salvogendut/V9958-tester/revision-b2-sram/firmware/README.md

# Revision B2 firmware

B2 uses the shared Revision B pinout and firmware source in
`../../firmware/main.c`. The SRAM adapter is transparent to the tester code.

```sh
export PICO_SDK_PATH=/path/to/pico-sdk
cmake -S revision-b2-sram/firmware -B revision-b2-sram/firmware/build -DPICO_BOARD=pico
cmake --build revision-b2-sram/firmware/build -j4
```

Send `R` or `r` over the Pico USB CDC serial port to repeat the test.
