salvogendut/V9958-tester/fabrication/gerbers/drill-report.txt

Drill report for V9958-Tester.kicad_pcb
Created on 2026-11-06T12:15:43

Copper Layer Stackup:
    =============================================================
    L1 :  F.Cu                      front
    L2 :  B.Cu                      back

Drill file 'V9958-Tester-PTH.drl' contains
    plated through holes:
    =============================================================
    T1  0.350mm  0.0138"  (97 holes))
    T2  0.400mm  0.0157"  (4 holes))
    T3  0.710mm  0.0280"  (2 holes))
    T4  0.800mm  0.0315"  (306 holes))
    T5  0.900mm  0.0354"  (70 holes))
    T6  1.000mm  0.0394"  (51 holes))
    T7  1.100mm  0.0433"  (4 holes))
    T8  1.300mm  0.0512"  (10 holes))

    Total plated holes count 544

Drill file 'V9958-Tester-NPTH.drl' contains
    unplated through holes:
    =============================================================
    T1  2.400mm  0.0945"  (2 holes))
    T2  3.200mm  0.1260"  (4 holes))

    Total unplated holes count 6
