salvogendut/V9958-tester/docs/BOM.csv

Quantity | References | Value / part | KiCad footprint | Notes
1 | A1 | Raspberry Pi Pico | Module:RaspberryPi_Pico_Common_THT | Original RP2040 Pico module; fit using two 1x20 THT socket strips
1 | C1 | 30pF trimmer | V9958-Tester:C_Trim_P5.00mm | 2-pin ceramic trimmer, 5.0 mm pitch
1 | C2 | 22pF | Capacitor_THT:C_Disc_D5.0mm_W2.5mm_P5.00mm
3 | C3 C4 C5 | 10n | Capacitor_THT:C_Disc_D5.0mm_W2.5mm_P5.00mm
1 | C6 | 100uF | Capacitor_THT:CP_Radial_D5.0mm_P2.00mm
13 | C7 C9 C10 C11 C12 C13 C14 C15 C16 C17 C18 C19 C20 | 100n | Capacitor_THT:C_Disc_D5.0mm_W2.5mm_P5.00mm
1 | C8 | 100n VBB | Capacitor_THT:C_Disc_D5.0mm_W2.5mm_P5.00mm
1 | C21 | 10uF | Capacitor_THT:CP_Radial_D5.0mm_P2.00mm
1 | C22 | 100n VCC1 | Capacitor_THT:C_Disc_D5.0mm_W2.5mm_P5.00mm
1 | C23 | 47uF VCC1 | Capacitor_THT:CP_Radial_D5.0mm_P2.00mm
1 | C24 | 100n VCC2 | Capacitor_THT:C_Disc_D5.0mm_W2.5mm_P5.00mm
1 | C25 | 47uF VCC2 | Capacitor_THT:CP_Radial_D5.0mm_P2.00mm
3 | C26 C27 C28 | 220uF | Capacitor_THT:CP_Radial_D8.0mm_P3.50mm
1 | D1 | GREEN PASS | LED_THT:LED_D5.0mm
1 | D2 | RED FAIL | LED_THT:LED_D5.0mm
1 | F1 | Bourns MF-RHT100 PTC 1.0A | Fuse:Fuse_Bourns_MF-RHT100 | 1.0 A hold / 1.8 A trip resettable fuse
4 | H1 H2 H3 H4 | M3 | MountingHole:MountingHole_3.2mm_M3
1 | J1 | OMEGA RGB DIN-8 | V9958-Tester:DIN8_Omega_THT | Omega-compatible THT DIN-8 socket; verify the chosen part against the supplied footprint
1 | L1 | 5.6uH | Inductor_THT:L_Axial_L14.0mm_D4.5mm_P15.24mm_Horizontal_Fastron_LACC
12 | R1 R2 R3 R14 R15 R16 R17 R18 R19 R20 R32 R40 | 10k | Resistor_THT:R_Axial_DIN0207_L6.3mm_D2.5mm_P7.62mm_Horizontal
1 | R4 | 470k | Resistor_THT:R_Axial_DIN0207_L6.3mm_D2.5mm_P7.62mm_Horizontal
4 | R5 R6 R7 R8 | 100 | Resistor_THT:R_Axial_DIN0207_L6.3mm_D2.5mm_P7.62mm_Horizontal
8 | R9 R10 R11 R12 R13 R30 R31 R39 | 1k | Resistor_THT:R_Axial_DIN0207_L6.3mm_D2.5mm_P7.62mm_Horizontal
3 | R21 R24 R27 | 470 | Resistor_THT:R_Axial_DIN0207_L6.3mm_D2.5mm_P7.62mm_Horizontal
6 | R22 R23 R25 R26 R28 R29 | 22k | Resistor_THT:R_Axial_DIN0207_L6.3mm_D2.5mm_P7.62mm_Horizontal
1 | R33 | 47k | Resistor_THT:R_Axial_DIN0207_L6.3mm_D2.5mm_P7.62mm_Horizontal
1 | R34 | 16k 1% PAL | Resistor_THT:R_Axial_DIN0207_L6.3mm_D2.5mm_P7.62mm_Horizontal | 1% metal-film resistor for CXA1645 PAL filter reference
3 | R35 R36 R37 | 75 | Resistor_THT:R_Axial_DIN0207_L6.3mm_D2.5mm_P7.62mm_Horizontal
1 | R38 | 1k sync/75R load | Resistor_THT:R_Axial_DIN0207_L6.3mm_D2.5mm_P7.62mm_Horizontal | Forms approximately 0.35 V CSYNC when terminated by 75 ohms at the display
1 | R41 | 120 | Resistor_THT:R_Axial_DIN0207_L6.3mm_D2.5mm_P7.62mm_Horizontal
1 | R42 | 180 | Resistor_THT:R_Axial_DIN0207_L6.3mm_D2.5mm_P7.62mm_Horizontal
1 | RN1 | 10k bussed | Resistor_THT:R_Array_SIP10 | 10-pin bussed/common SIP network; common pin is pin 1
1 | SW1 | TEST | Button_Switch_THT:SW_PUSH_6mm_H7.3mm
1 | TP1 | 5V | TestPoint:TestPoint_THTPad_D2.0mm_Drill1.0mm
1 | TP2 | 3V3 | TestPoint:TestPoint_THTPad_D2.0mm_Drill1.0mm
1 | TP3 | GND | TestPoint:TestPoint_THTPad_D2.0mm_Drill1.0mm
1 | TP4 | CPUCLK | TestPoint:TestPoint_THTPad_D2.0mm_Drill1.0mm
1 | TP5 | HSYNC | TestPoint:TestPoint_THTPad_D2.0mm_Drill1.0mm
1 | TP6 | CSYNC | TestPoint:TestPoint_THTPad_D2.0mm_Drill1.0mm
1 | TP7 | RED | TestPoint:TestPoint_THTPad_D2.0mm_Drill1.0mm
1 | TP8 | GREEN | TestPoint:TestPoint_THTPad_D2.0mm_Drill1.0mm
1 | TP9 | BLUE | TestPoint:TestPoint_THTPad_D2.0mm_Drill1.0mm
1 | U1 | SN74LVC245AN | Package_DIP:DIP-20_W7.62mm_Socket_LongPads | Use LVC, powered at 3.3 V; DIP socket recommended
1 | U2 | SN74AHCT244N | Package_DIP:DIP-20_W7.62mm_Socket_LongPads | Use AHCT, powered at 5 V; DIP socket recommended
1 | U3 | V9958 DUT | V9958-Tester:SDIP-64_W19.05mm_P1.778mm_Socket | DUT; use a quality 64-pin 1.778 mm-pitch, 19.05 mm-row socket/ZIF
1 | U4 | SN74LVC244AN | Package_DIP:DIP-20_W7.62mm_Socket_LongPads | Use LVC, powered at 3.3 V; DIP socket recommended
1 | U5 | 41464 VRAM L0 | Package_DIP:DIP-18_W7.62mm_Socket_LongPads | 64Kx4 DRAM, 120 ns or faster; socket recommended
1 | U6 | 41464 VRAM H0 | Package_DIP:DIP-18_W7.62mm_Socket_LongPads | 64Kx4 DRAM, 120 ns or faster; socket recommended
1 | U7 | 41464 VRAM L1 | Package_DIP:DIP-18_W7.62mm_Socket_LongPads | 64Kx4 DRAM, 120 ns or faster; socket recommended
1 | U8 | 41464 VRAM H1 | Package_DIP:DIP-18_W7.62mm_Socket_LongPads | 64Kx4 DRAM, 120 ns or faster; socket recommended
1 | U9 | CXA1645P RGB buffer | Package_DIP:DIP-24_W10.16mm_Socket_LongPads | Sony CXA1645P DIP-24; socket recommended; used for buffered DIN RGB only
1 | Y1 | 21.477270MHz | Crystal:Crystal_HC49-U_Vertical | Parallel-resonant fundamental crystal, HC49/U THT
