salvogendut/V9958-tester/revision-b2-sram/docs/BOM.csv

Quantity | References | Value / part | KiCad footprint
1 | A1 | Raspberry Pi Pico | Module:RaspberryPi_Pico_Common_THT
1 | C1 | 30pF trimmer | V9958-Tester:C_Trim_P5.00mm
1 | C10 | 100n U1 | Capacitor_THT:C_Disc_D5.0mm_W2.5mm_P5.00mm
1 | C11 | 100n U4 | Capacitor_THT:C_Disc_D5.0mm_W2.5mm_P5.00mm
1 | C12 | 100n SRAM | Capacitor_THT:C_Disc_D5.0mm_W2.5mm_P5.00mm
1 | C13 | 100n U6 | Capacitor_THT:C_Disc_D5.0mm_W2.5mm_P5.00mm
1 | C14 | 100n U7 | Capacitor_THT:C_Disc_D5.0mm_W2.5mm_P5.00mm
1 | C16 | 100n VIDEO | Capacitor_THT:C_Disc_D5.0mm_W2.5mm_P5.00mm
1 | C2 | 22pF | Capacitor_THT:C_Disc_D5.0mm_W2.5mm_P5.00mm
3 | C3 C4 C5 | 10n | Capacitor_THT:C_Disc_D5.0mm_W2.5mm_P5.00mm
1 | C6 | 100uF | Capacitor_THT:CP_Radial_D5.0mm_P2.00mm
1 | C7 | 100n VDP | Capacitor_THT:C_Disc_D5.0mm_W2.5mm_P5.00mm
1 | C8 | 100n DAC | Capacitor_THT:C_Disc_D5.0mm_W2.5mm_P5.00mm
1 | C9 | 100n VBB | Capacitor_THT:C_Disc_D5.0mm_W2.5mm_P5.00mm
1 | D1 | GREEN PASS | LED_THT:LED_D5.0mm
1 | D2 | RED FAIL | LED_THT:LED_D5.0mm
1 | F1 | Bourns MF-RHT100 PTC 1.0A | Fuse:Fuse_Bourns_MF-RHT100
1 | J1 | VIDEO DAUGHTERBOARD | Connector_IDC:IDC-Header_2x03_P2.54mm_Vertical
1 | L1 | 5.6uH | Inductor_THT:L_Axial_L14.0mm_D4.5mm_P15.24mm_Horizontal_Fastron_LACC
9 | R1 R8 R9 R10 R11 R12 R13 R14 R20 | 10k | Resistor_THT:R_Axial_DIN0207_L6.3mm_D2.5mm_P7.62mm_Horizontal
7 | R15 R16 R17 R18 R19 R34 R35 | 1k | Resistor_THT:R_Axial_DIN0207_L6.3mm_D2.5mm_P7.62mm_Horizontal
1 | R2 | 470k | Resistor_THT:R_Axial_DIN0207_L6.3mm_D2.5mm_P7.62mm_Horizontal
4 | R21 R22 R23 R24 | 47 | Resistor_THT:R_Axial_DIN0207_L6.3mm_D2.5mm_P7.62mm_Horizontal
3 | R25 R28 R31 | 470 | Resistor_THT:R_Axial_DIN0207_L6.3mm_D2.5mm_P7.62mm_Horizontal
6 | R26 R27 R29 R30 R32 R33 | 22k | Resistor_THT:R_Axial_DIN0207_L6.3mm_D2.5mm_P7.62mm_Horizontal
5 | R3 R4 R5 R6 R7 | 330 | Resistor_THT:R_Axial_DIN0207_L6.3mm_D2.5mm_P7.62mm_Horizontal
1 | RN1 | 10k bussed | Resistor_THT:R_Array_SIP10
1 | U1 | SN74LVC245AN | Package_DIP:DIP-20_W7.62mm_Socket_LongPads
1 | U3 | V9958 DUT | V9958-Tester:SDIP-64_W19.05mm_P1.778mm_Socket
1 | U4 | SN74LVC244AN | Package_DIP:DIP-20_W7.62mm_Socket_LongPads
1 | U5 | AS6C1008-55PCN 128Kx8 SRAM | Package_DIP:DIP-32_W15.24mm_Socket_LongPads
1 | U6 | SN74AHCT573N row-address latch | Package_DIP:DIP-20_W7.62mm_Socket_LongPads
1 | U7 | SN74AHCT08N CAS-to-OE gate | Package_DIP:DIP-14_W7.62mm_Socket_LongPads
1 | Y1 | 21.477270MHz | Crystal:Crystal_HC49-U_Vertical
