salvogendut/V9958-tester/video-daughterboard/docs/BOM.csv

Quantity | References | Value / part | KiCad footprint
3 | C1 C2 C3 | 100n | Capacitor_THT:C_Disc_D5.0mm_W2.5mm_P5.00mm
1 | C10 | 47uF VCC2 | Capacitor_THT:CP_Radial_D5.0mm_P2.00mm
3 | C11 C12 C13 | 220uF | Capacitor_THT:CP_Radial_D8.0mm_P3.50mm
1 | C4 | 100n YCLP | Capacitor_THT:C_Disc_D5.0mm_W2.5mm_P5.00mm
1 | C5 | 100n IREF | Capacitor_THT:C_Disc_D5.0mm_W2.5mm_P5.00mm
1 | C6 | 10uF | Capacitor_THT:CP_Radial_D5.0mm_P2.00mm
1 | C7 | 100n VCC1 | Capacitor_THT:C_Disc_D5.0mm_W2.5mm_P5.00mm
1 | C8 | 47uF VCC1 | Capacitor_THT:CP_Radial_D5.0mm_P2.00mm
1 | C9 | 100n VCC2 | Capacitor_THT:C_Disc_D5.0mm_W2.5mm_P5.00mm
1 | J1 | FROM REV B | Connector_IDC:IDC-Header_2x03_P2.54mm_Vertical
1 | J2 | OMEGA RGB DIN-8 | V9958-Video-Daughterboard:DIN8_Omega_THT
1 | R1 | 47k | Resistor_THT:R_Axial_DIN0207_L6.3mm_D2.5mm_P7.62mm_Horizontal
1 | R10 | 180 | Resistor_THT:R_Axial_DIN0207_L6.3mm_D2.5mm_P7.62mm_Horizontal
1 | R2 | 16k 1% PAL | Resistor_THT:R_Axial_DIN0207_L6.3mm_D2.5mm_P7.62mm_Horizontal
3 | R3 R4 R5 | 75 | Resistor_THT:R_Axial_DIN0207_L6.3mm_D2.5mm_P7.62mm_Horizontal
1 | R6 | 1k sync/75R load | Resistor_THT:R_Axial_DIN0207_L6.3mm_D2.5mm_P7.62mm_Horizontal
1 | R7 | 1k | Resistor_THT:R_Axial_DIN0207_L6.3mm_D2.5mm_P7.62mm_Horizontal
1 | R8 | 10k | Resistor_THT:R_Axial_DIN0207_L6.3mm_D2.5mm_P7.62mm_Horizontal
1 | R9 | 120 | Resistor_THT:R_Axial_DIN0207_L6.3mm_D2.5mm_P7.62mm_Horizontal
1 | U1 | CXA1645P RGB buffer | Package_DIP:DIP-24_W10.16mm_Socket_LongPads
