salvogendut/V9958-tester/revision-b2-sram/fabrication/README.md

# Revision B2 SRAM fabrication package

`V9958-Tester-RevB2-SRAM-B2-gerbers.zip` contains the final Gerber and separate
plated/non-plated Excellon drill files.

- Two layers, FR-4, 1.6 mm nominal thickness.
- 1 oz copper is suitable for the prototype.
- Minimum routed track 0.25 mm; minimum copper clearance 0.20 mm.
- Minimum copper-to-edge clearance 0.40 mm.
- Board size 160 x 110 mm.

Review the Gerbers, socket footprints and exact AS6C1008-55PCN part before
ordering. This revision is experimental and has not been electrically
qualified against V9958 memory timing.
