salvogendut/V9958-tester/video-daughterboard/fabrication/README.md

# RGB DIN daughterboard fabrication package

`V9958-Video-Daughterboard-B0-gerbers.zip` contains the final Gerber and
separate plated and non-plated Excellon drill files.

- Two layers, FR-4, 1.6 mm nominal thickness.
- 1 oz copper is suitable for the prototype.
- Minimum routed track 0.25 mm; minimum copper clearance 0.20 mm.
- Minimum copper-to-edge clearance 0.40 mm.
- Board size 120 x 80 mm.

Verify the selected DIN-8 socket against the supplied footprint before ordering.
