salvogendut/V9958-tester/revision-b/docs/TEST-PROCEDURE.md

# Revision B test procedure

## Before applying power

1. Leave A1, U1, U3, U4 and U5-U8 out. Inspect for shorts, reversed polarized
   parts and offset sockets. RN1 must be a bussed 10 kOhm network with common
   pin 1 at the marked end.
2. Check resistance between +5 V and GND. Investigate a near short.
3. Power from a current-limited USB source. Confirm about 5 V at TP1 and 3.3 V
   on Pico pin 36, then power off and discharge the board.
4. Fit U1 and U4, the four known-good 41464s, the Pico and a known-good V9958.
   Match every socket notch and pin-1 mark.

## Functional run

1. Open the Pico USB CDC serial port and apply power. The test begins after
   approximately 1.5 seconds.
2. Green D1 indicates all stages passed. Red D2 indicates failure; serial output
   reports the stage and measured values.
3. Send `R` or `r` over USB serial to repeat the test. Power off before changing
   the V9958, VRAM or logic devices.
4. For monitor output, power off and attach the optional daughterboard using a
   keyed straight-through 2x3 IDC cable. Align the pin-1 stripe at both ends.

Expected signals include CPUCLK near 3.58 MHz at TP3 and CSYNC near 15.6 kHz at
TP4. TP5-TP7 expose raw loaded red, green and blue. These RGB points include a
large DC offset and are not direct 75-ohm monitor outputs.
