salvogendut/V9958-tester/video-daughterboard/docs/VALIDATION.md

# RGB DIN daughterboard validation record

Date: 2026-11-06

- KiCad version: 10.0.8.
- Schematic ERC: 0 violations.
- PCB DRC: 0 violations.
- Unconnected PCB items: 0.
- Schematic/PCB parity issues: 0.
- Board: 120 x 80 mm, 36 footprints, 98 pads and 0 SMD pads.
- Route: 213 tracks/vias, including 2 vias, and two filled GND zones.
- 3D/top renders and the assembly SVG were visually inspected.
- Gerber archive SHA-256: `07dd638bc96e5c94f20ed7453a713fc367b8748f9f50ecfc94e680a39f0738a5`.

The board remains **PROTOTYPE / UNVALIDATED** until the exact DIN socket, IDC
cable orientation, CXA1645 levels and compatibility with the intended Omega RGB
cable/display have been physically verified.
