salvogendut/V9958-tester/docs/V9958-Tester-Schematic.pdf

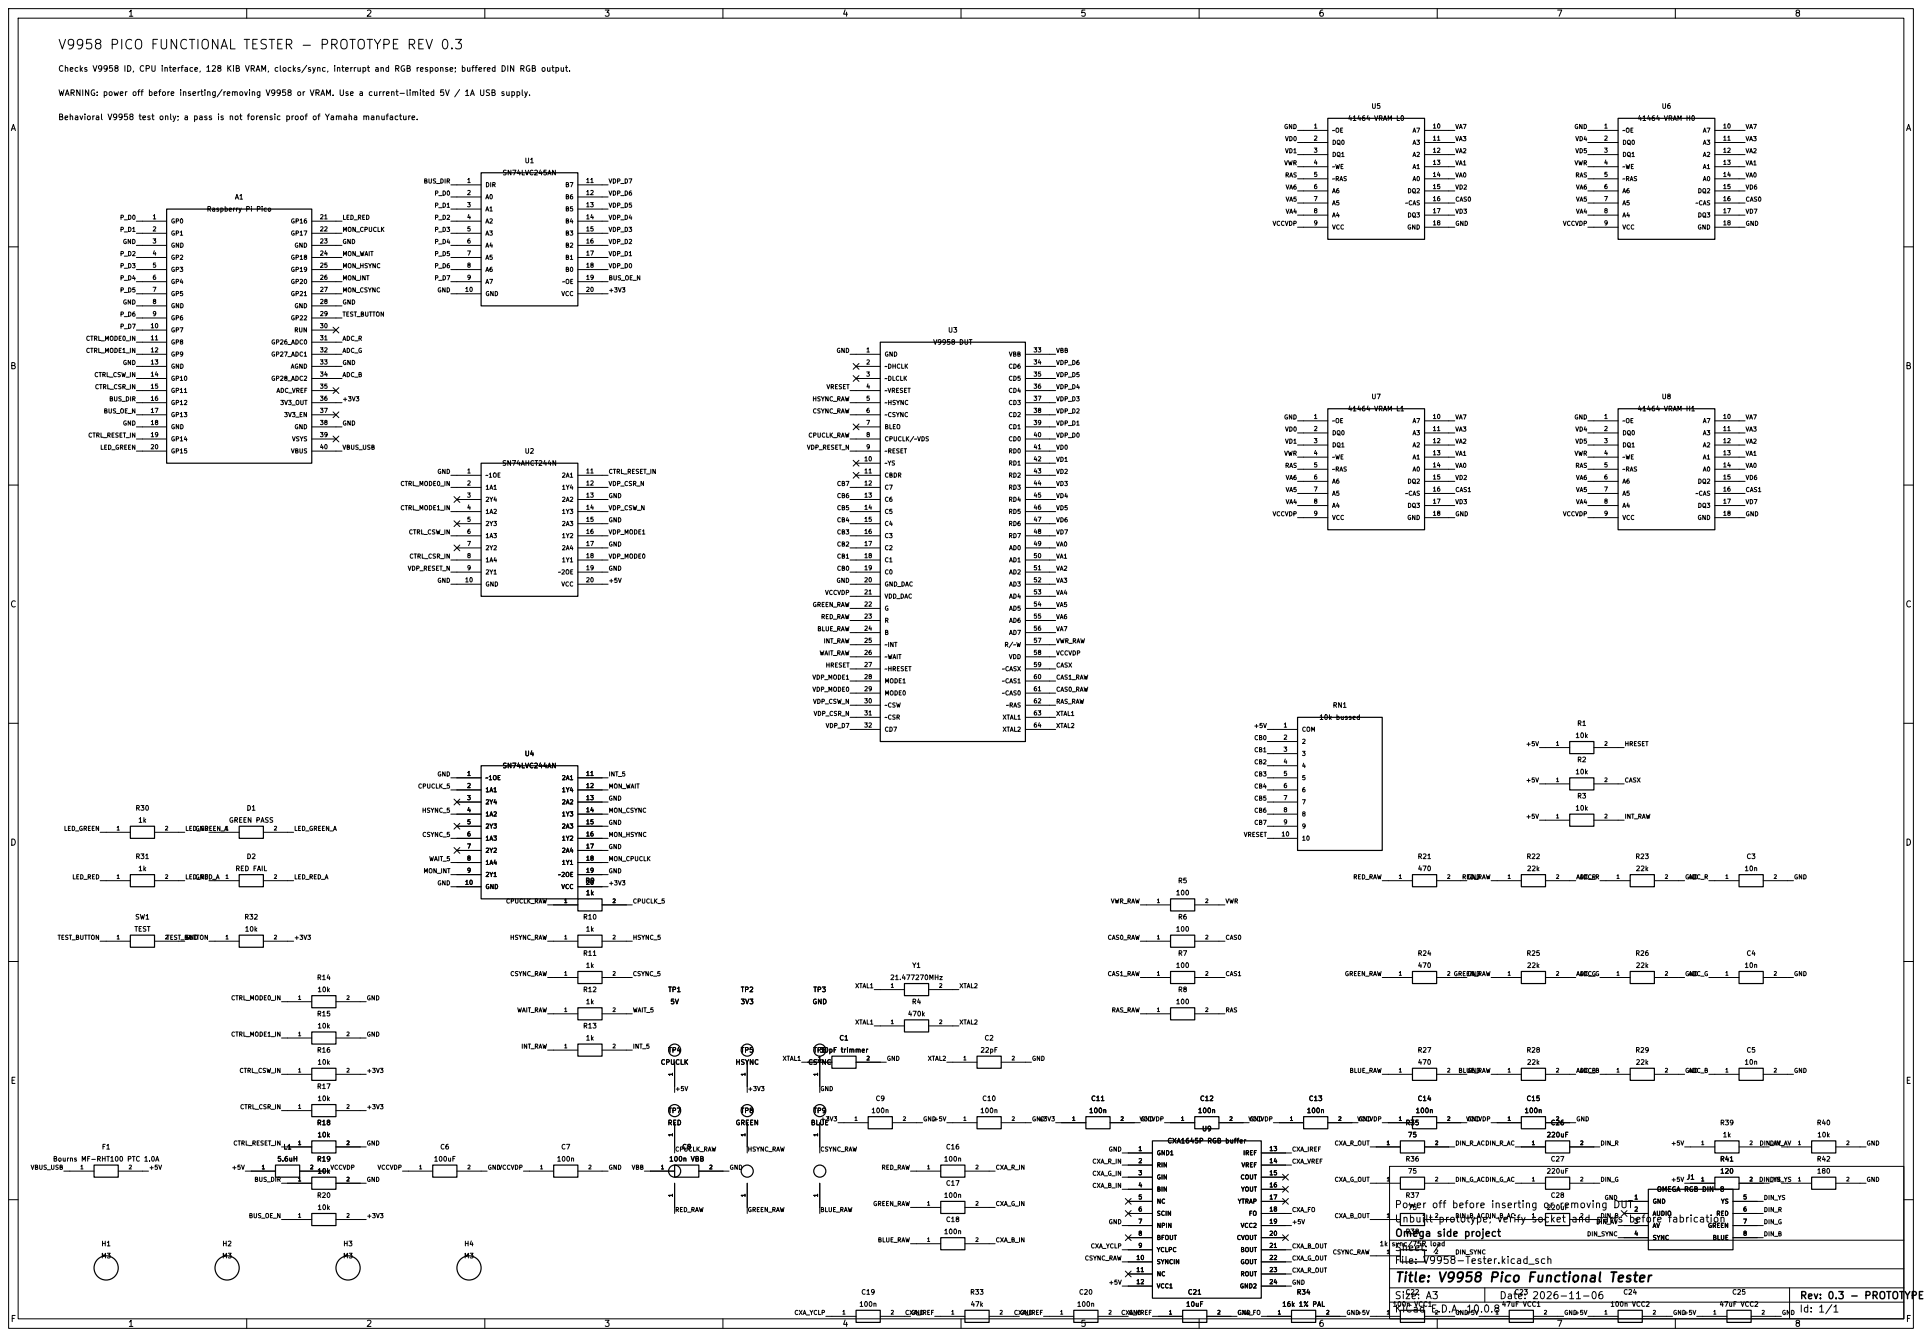
[picture p9: page 1]

VD2 V9958 PICO FUNCTIONAL TESTER - PROTOTYPE REV 0.3

Checks V9958 ID, CPU interface, 128 KiB VRAM, clocks/sync, interrupt and RGB response; buffered DIN RGB output. WARNING: power off before inserting/removing V9958 or VRAM. Use a current-limited 5V / 1A USB supply. Behavioral V9958 test only; a pass is not forensic proof of Yamaha manufacture.

Power off before inserting or removing DUT
Omega side project
