salvogendut/V9958-tester/revision-b2-sram/docs/V9958-Tester-RevB2-SRAM-Schematic.pdf

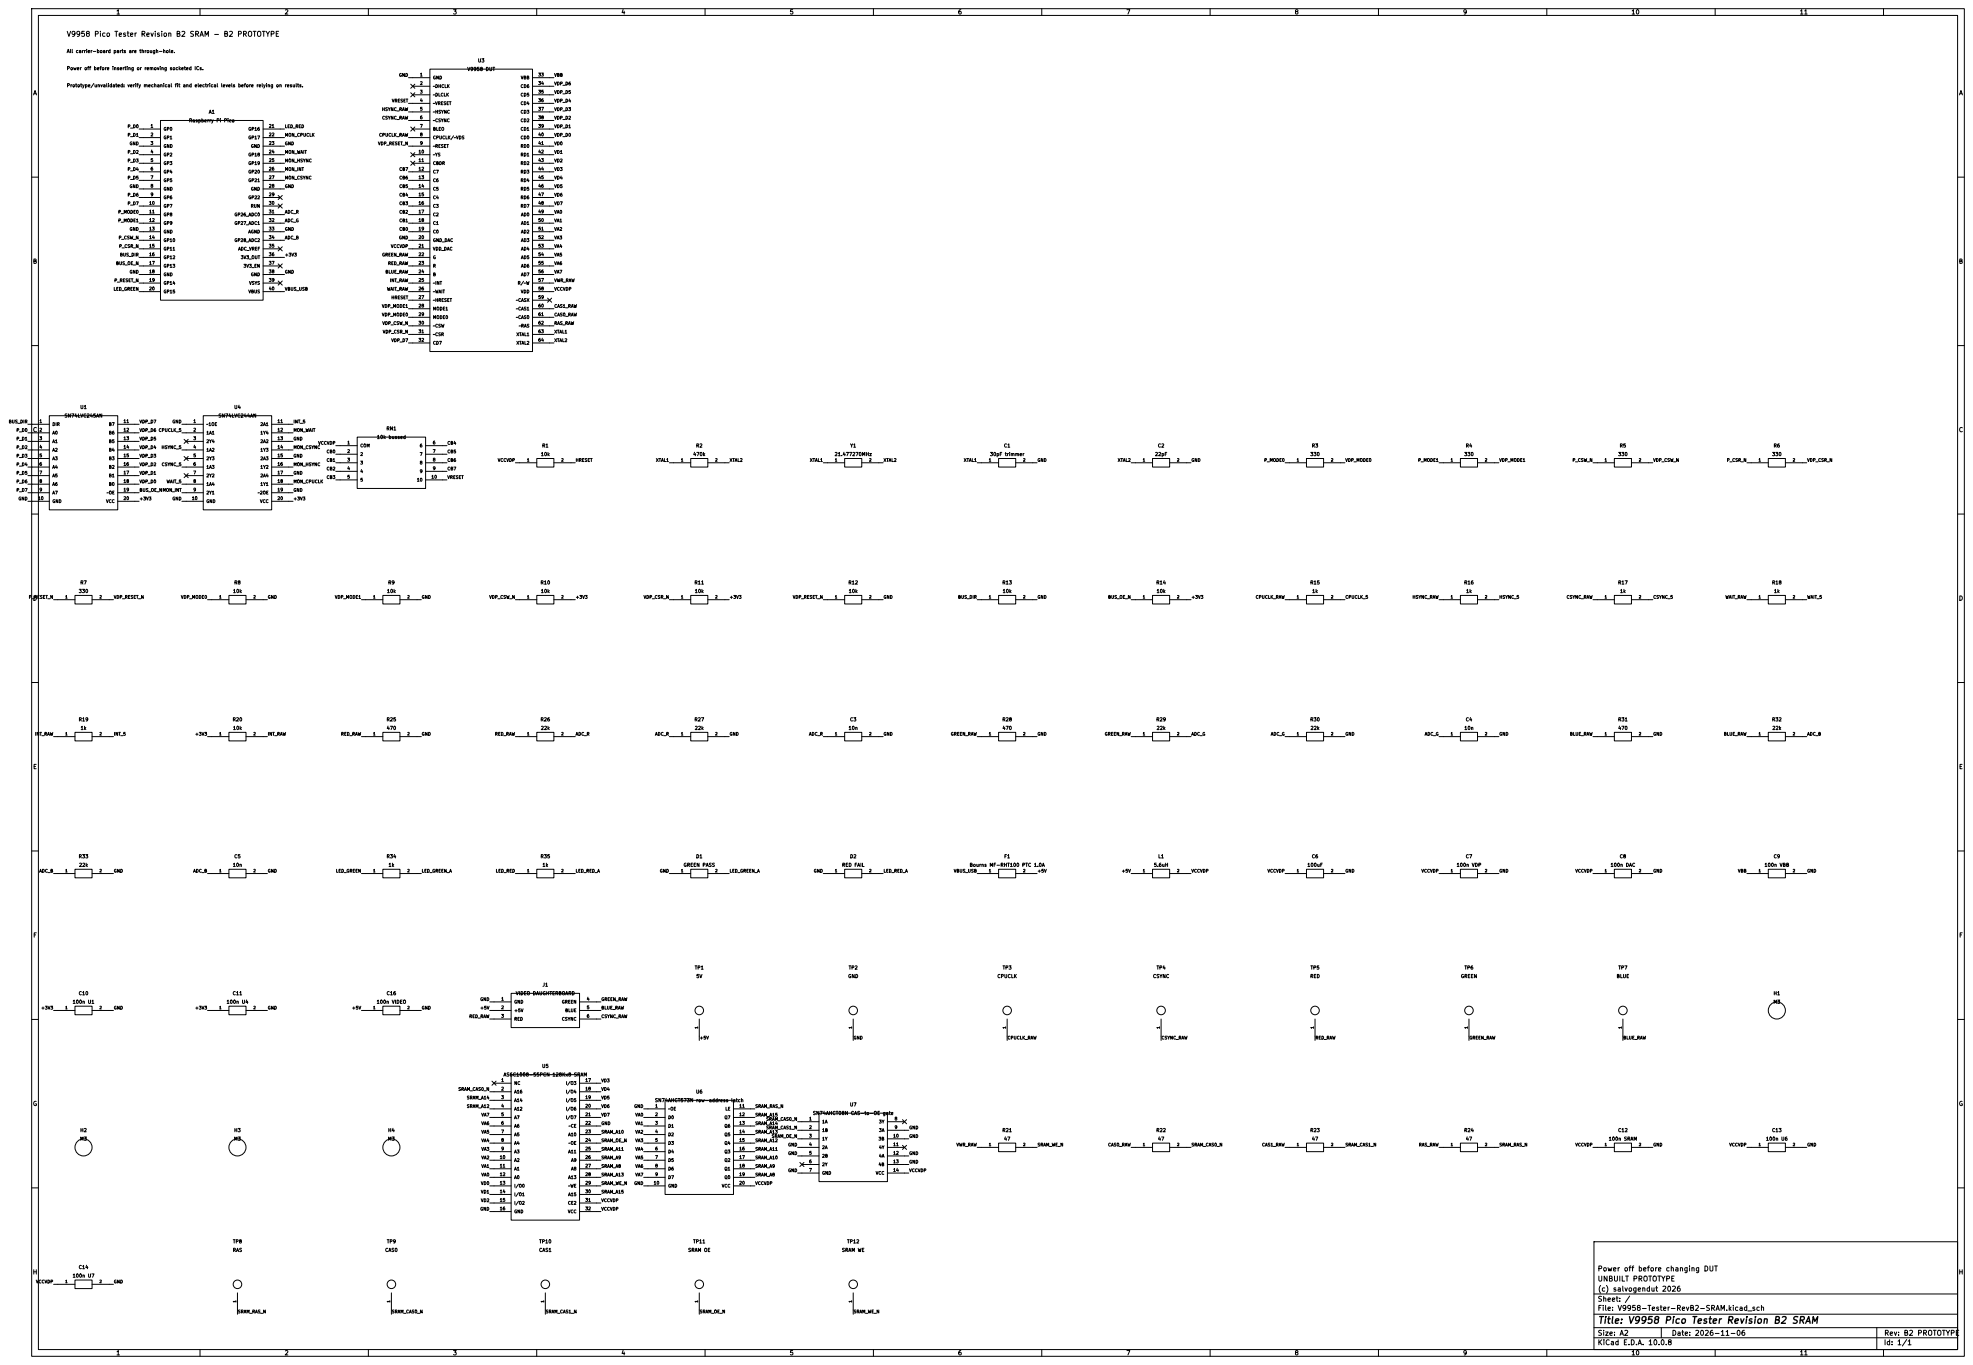
[picture p10: page 1]

VA4 GND Prototype/unvalidated: verify mechanical fit and electrical levels before relying on results. Power off before inserting or removing socketed ICs. All carrier-board parts are through-hole. V9958 Pico Tester Revision B2 SRAM - B2 PROTOTYPE

SN74AHCT08N CAS-to-OE gate

Power off before changing DUT
UNBUILT PROTOTYPE
(c) salvogendut 2026
Sheet: /
File: V9958-Tester-RevB2-SRAM.kicad_sch
Title: V9958 Pico Tester Revision B2 SRAM

Size: A2 | Rev: B2 PROTOTYPE
KiCad E.D.A. 10.0.8 | Id: 1/1
