salvogendut/V9958-tester/revision-b/docs/V9958-Tester-RevB-Schematic.pdf

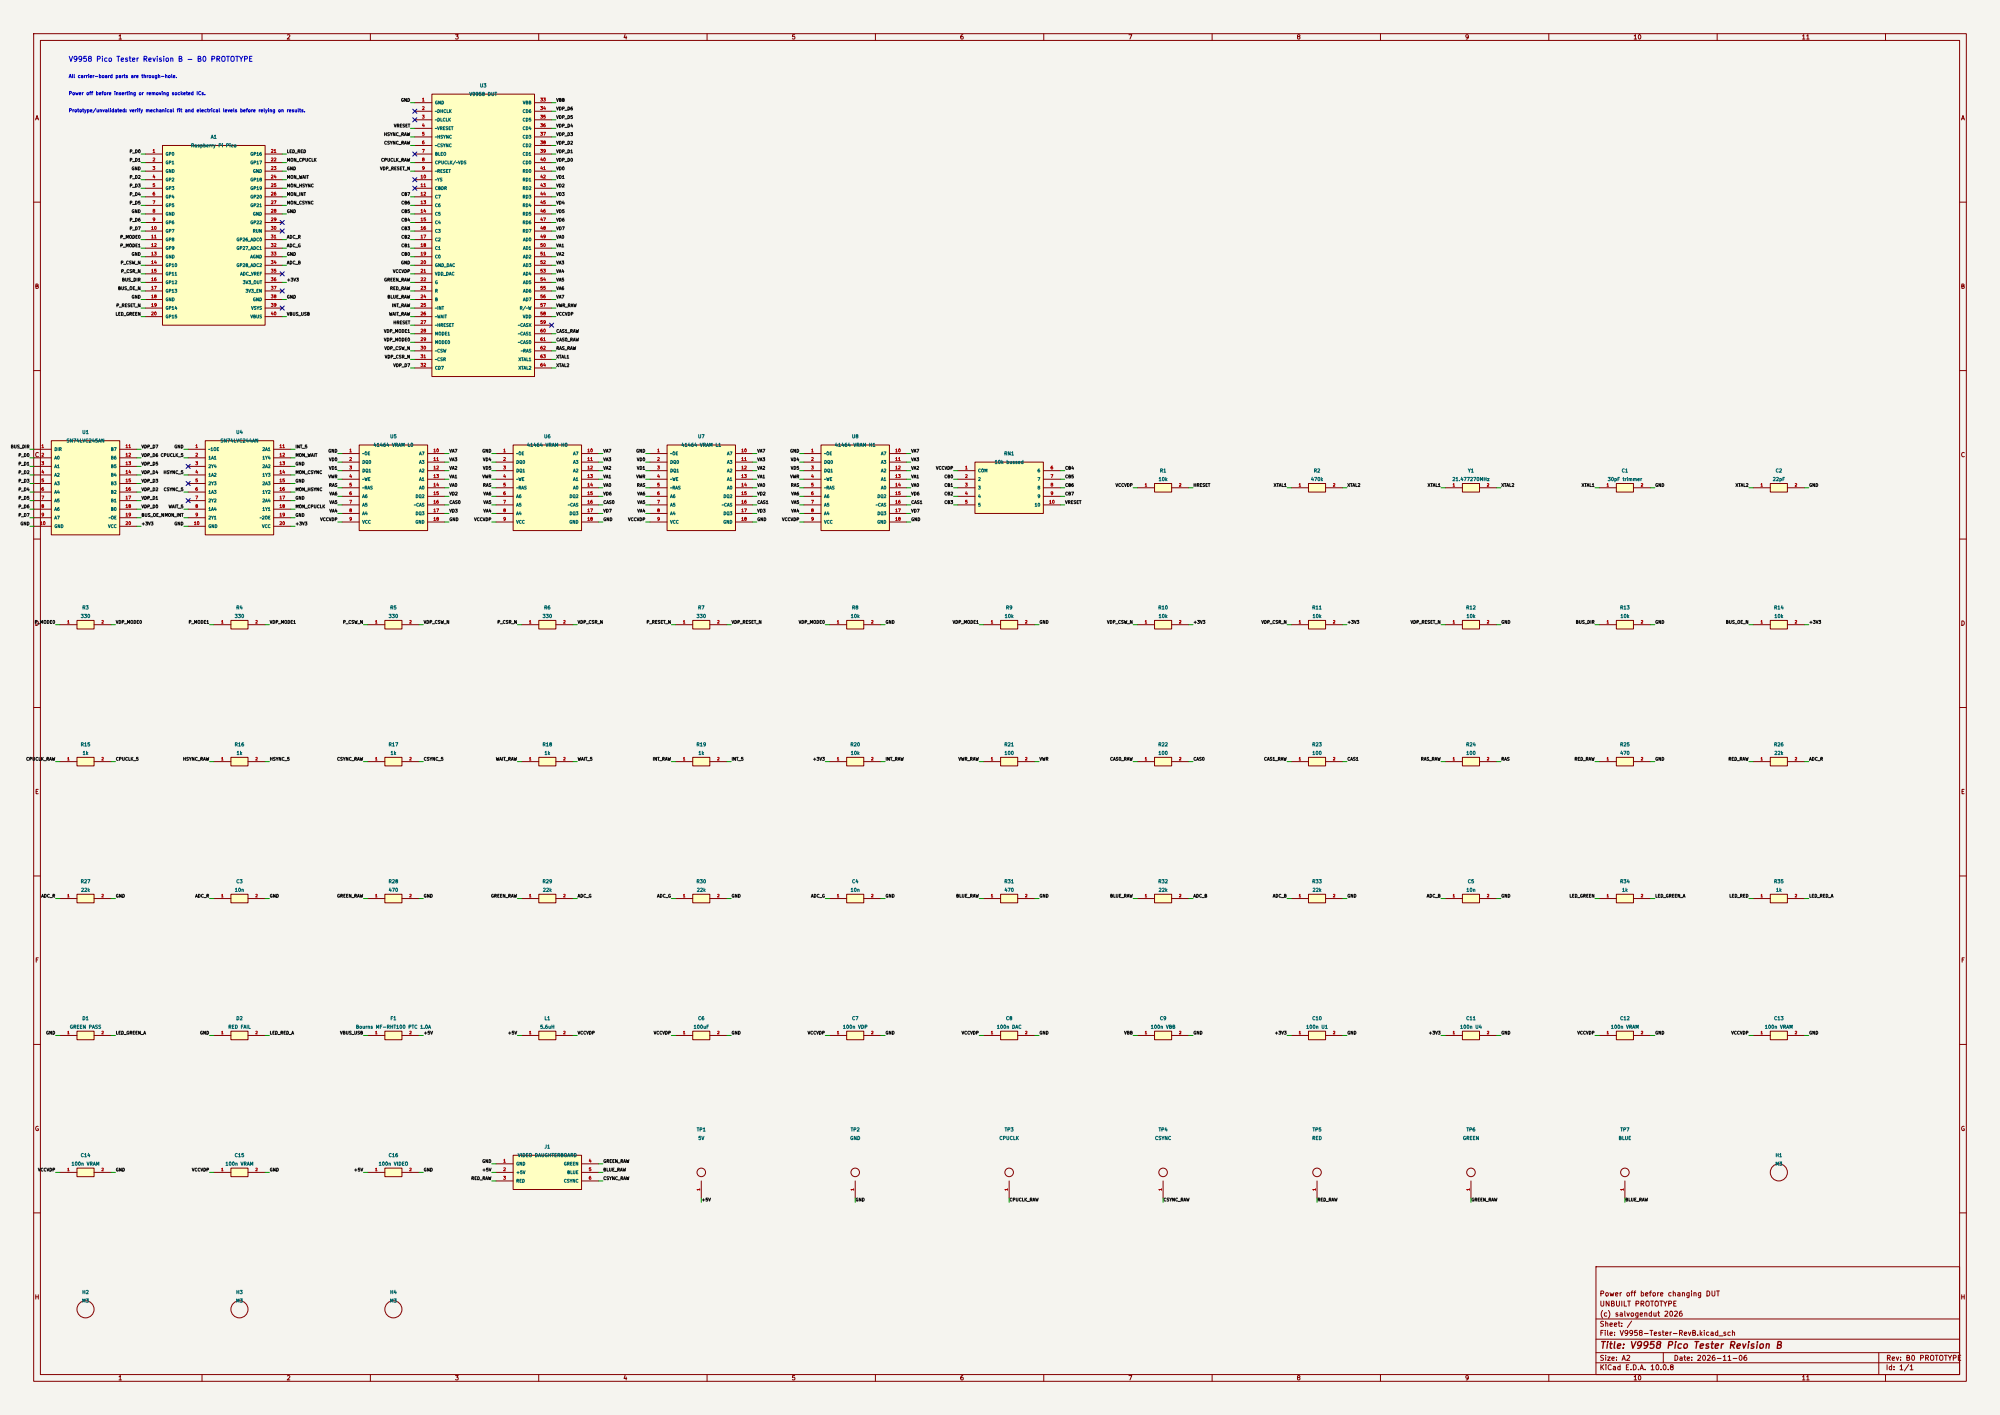
[picture p11: page 1]

Prototype/unvalidated: verify mechanical fit and electrical levels before relying on results. Power off before inserting or removing socketed ICs. All carrier-board parts are through-hole. V9958 Pico Tester Revision B - B0 PROTOTYPE

Power off before changing DUT
UNBUILT PROTOTYPE
(c) salvogendut 2026
Sheet: /
File: V9958-Tester-RevB.kicad_sch
Title: V9958 Pico Tester Revision B

Size: A2 | Rev: B0 PROTOTYPE
KiCad E.D.A. 10.0.8 | Id: 1/1
