salvogendut/V9958-tester/video-daughterboard/docs/V9958-Video-Daughterboard-Schematic.pdf

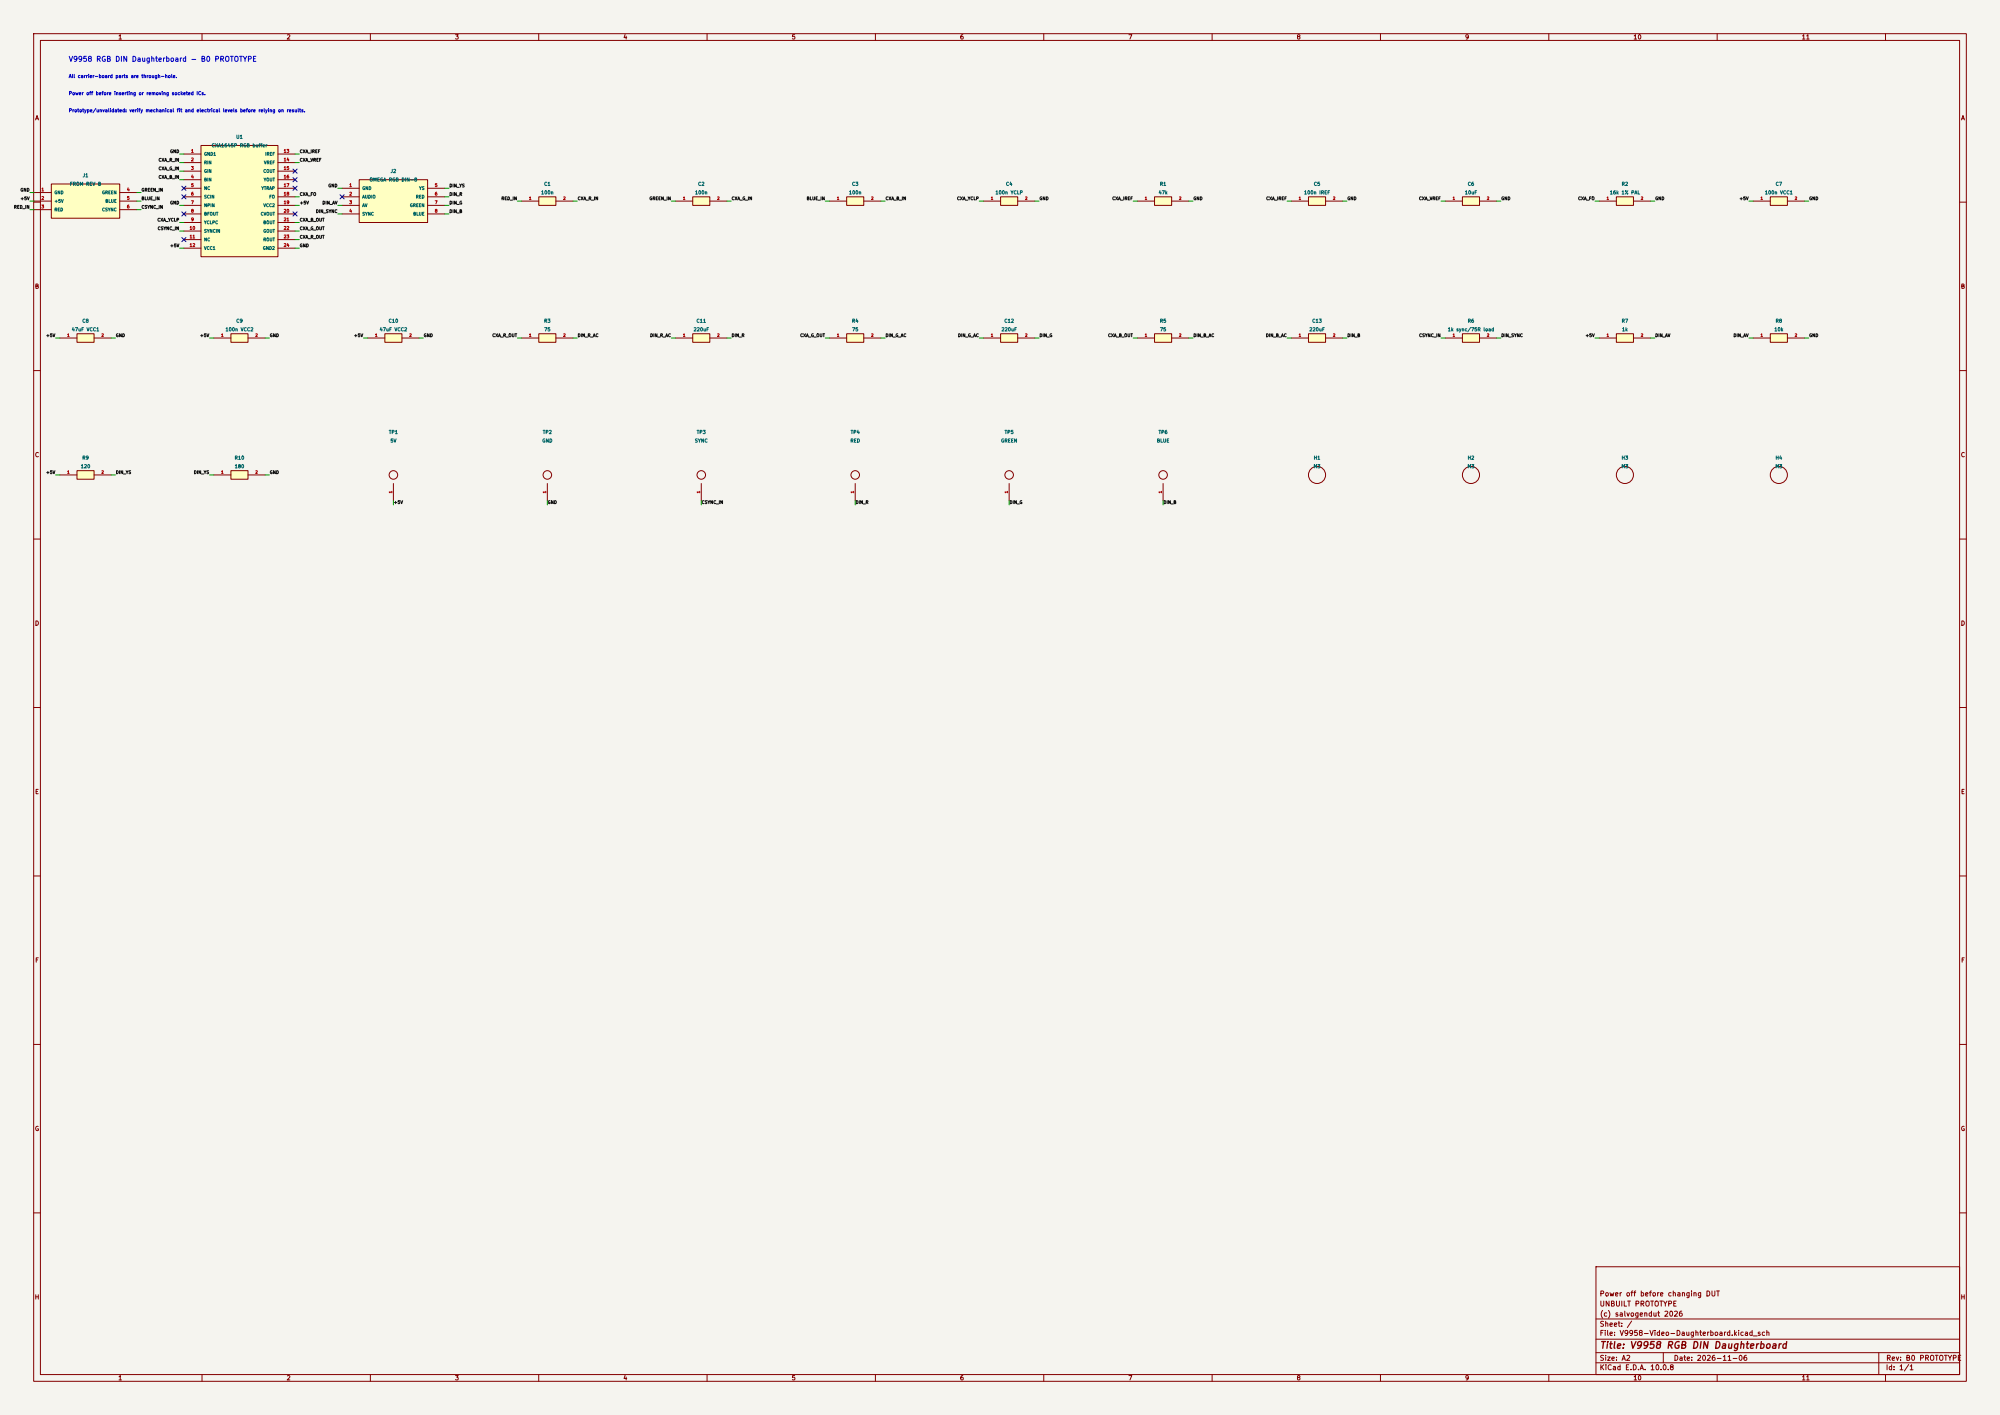
[picture p12: page 1]

DIN_SYNC Power off before inserting or removing socketed ICs. Prototype/unvalidated: verify mechanical fit and electrical levels before relying on results. All carrier-board parts are through-hole. V9958 RGB DIN Daughterboard - B0 PROTOTYPE

Power off before changing DUT
UNBUILT PROTOTYPE
(c) salvogendut 2026
Sheet: /
File: V9958-Video-Daughterboard.kicad_sch
Title: V9958 RGB DIN Daughterboard

Size: A2 | Rev: B0 PROTOTYPE
KiCad E.D.A. 10.0.8 | Id: 1/1
