salvogendut/V9958-tester/(list of files, drawings)

Other design files:
docs/unrouted.dsn
revision-b2-sram/docs/unrouted.dsn
revision-b/docs/unrouted.dsn
video-daughterboard/docs/unrouted.dsn
