salvogendut/V9958-tester/revision-b2-sram/V9958-Tester-RevB2-SRAM.kicad_pcb

## KiCad design revision-b2-sram/V9958-Tester-RevB2-SRAM.kicad_pcb (2026-11-06)

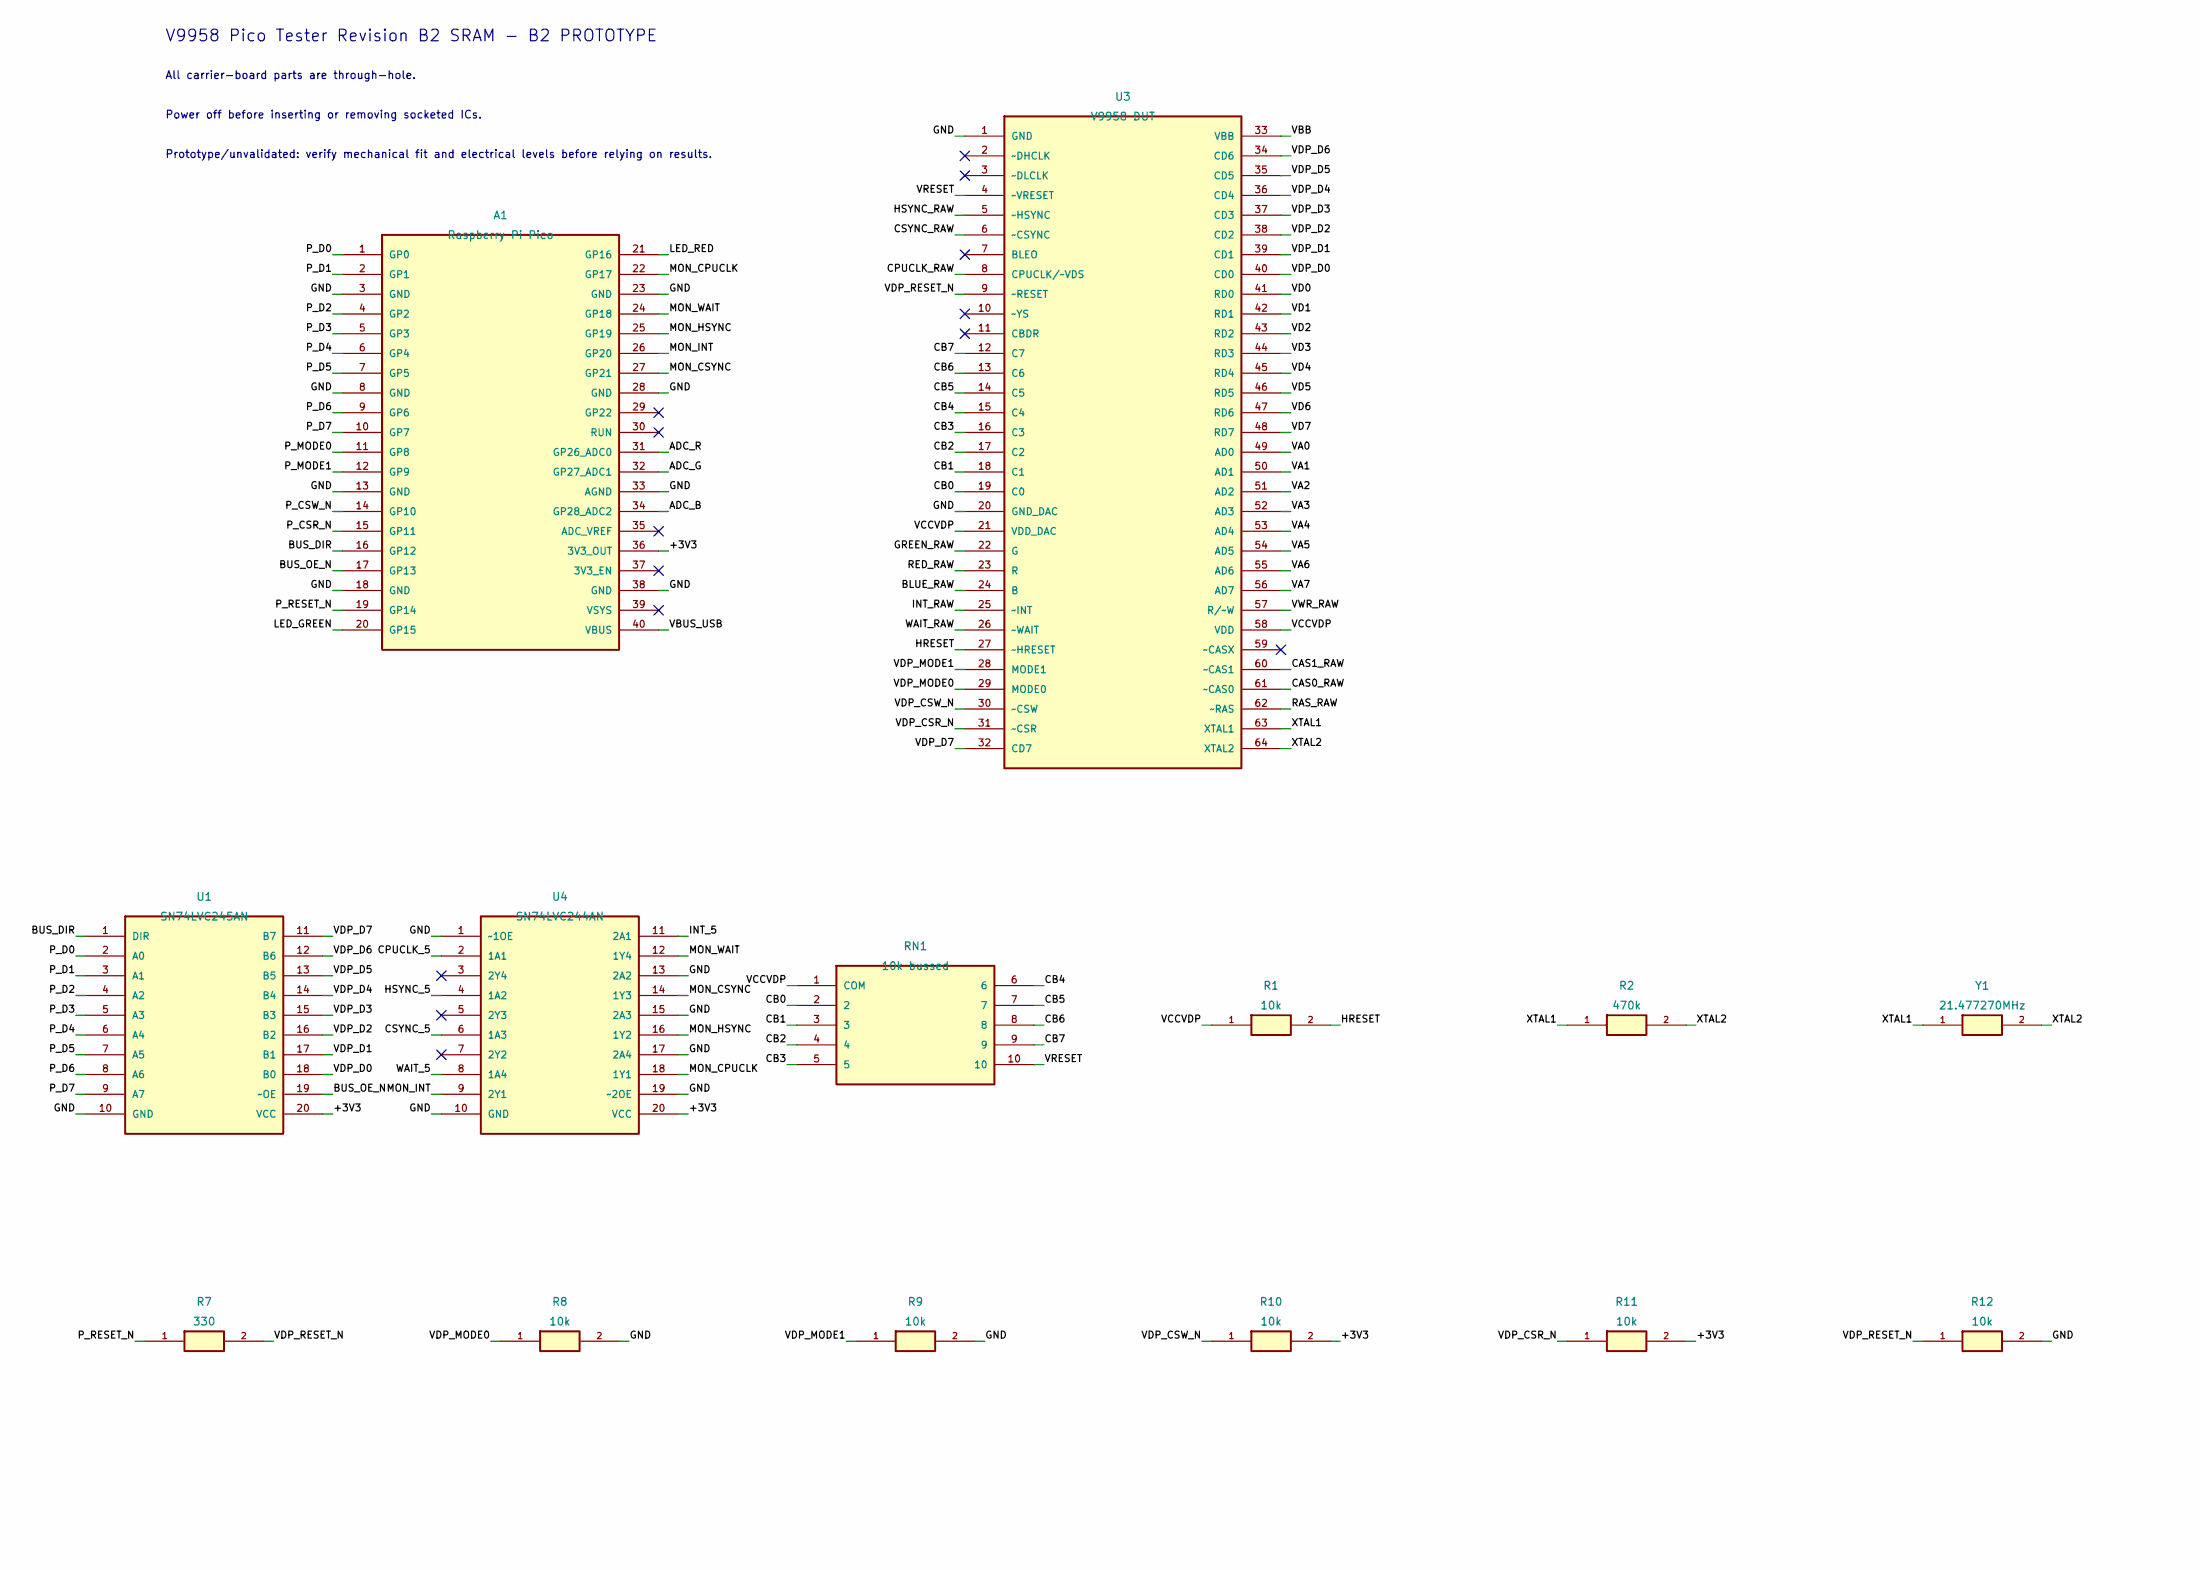
[picture p13: schematic V9958-Tester-RevB2-SRAM.kicad_sch, V9958 Pico Tester Revision B2 SRAM, part in row 1, column 1]

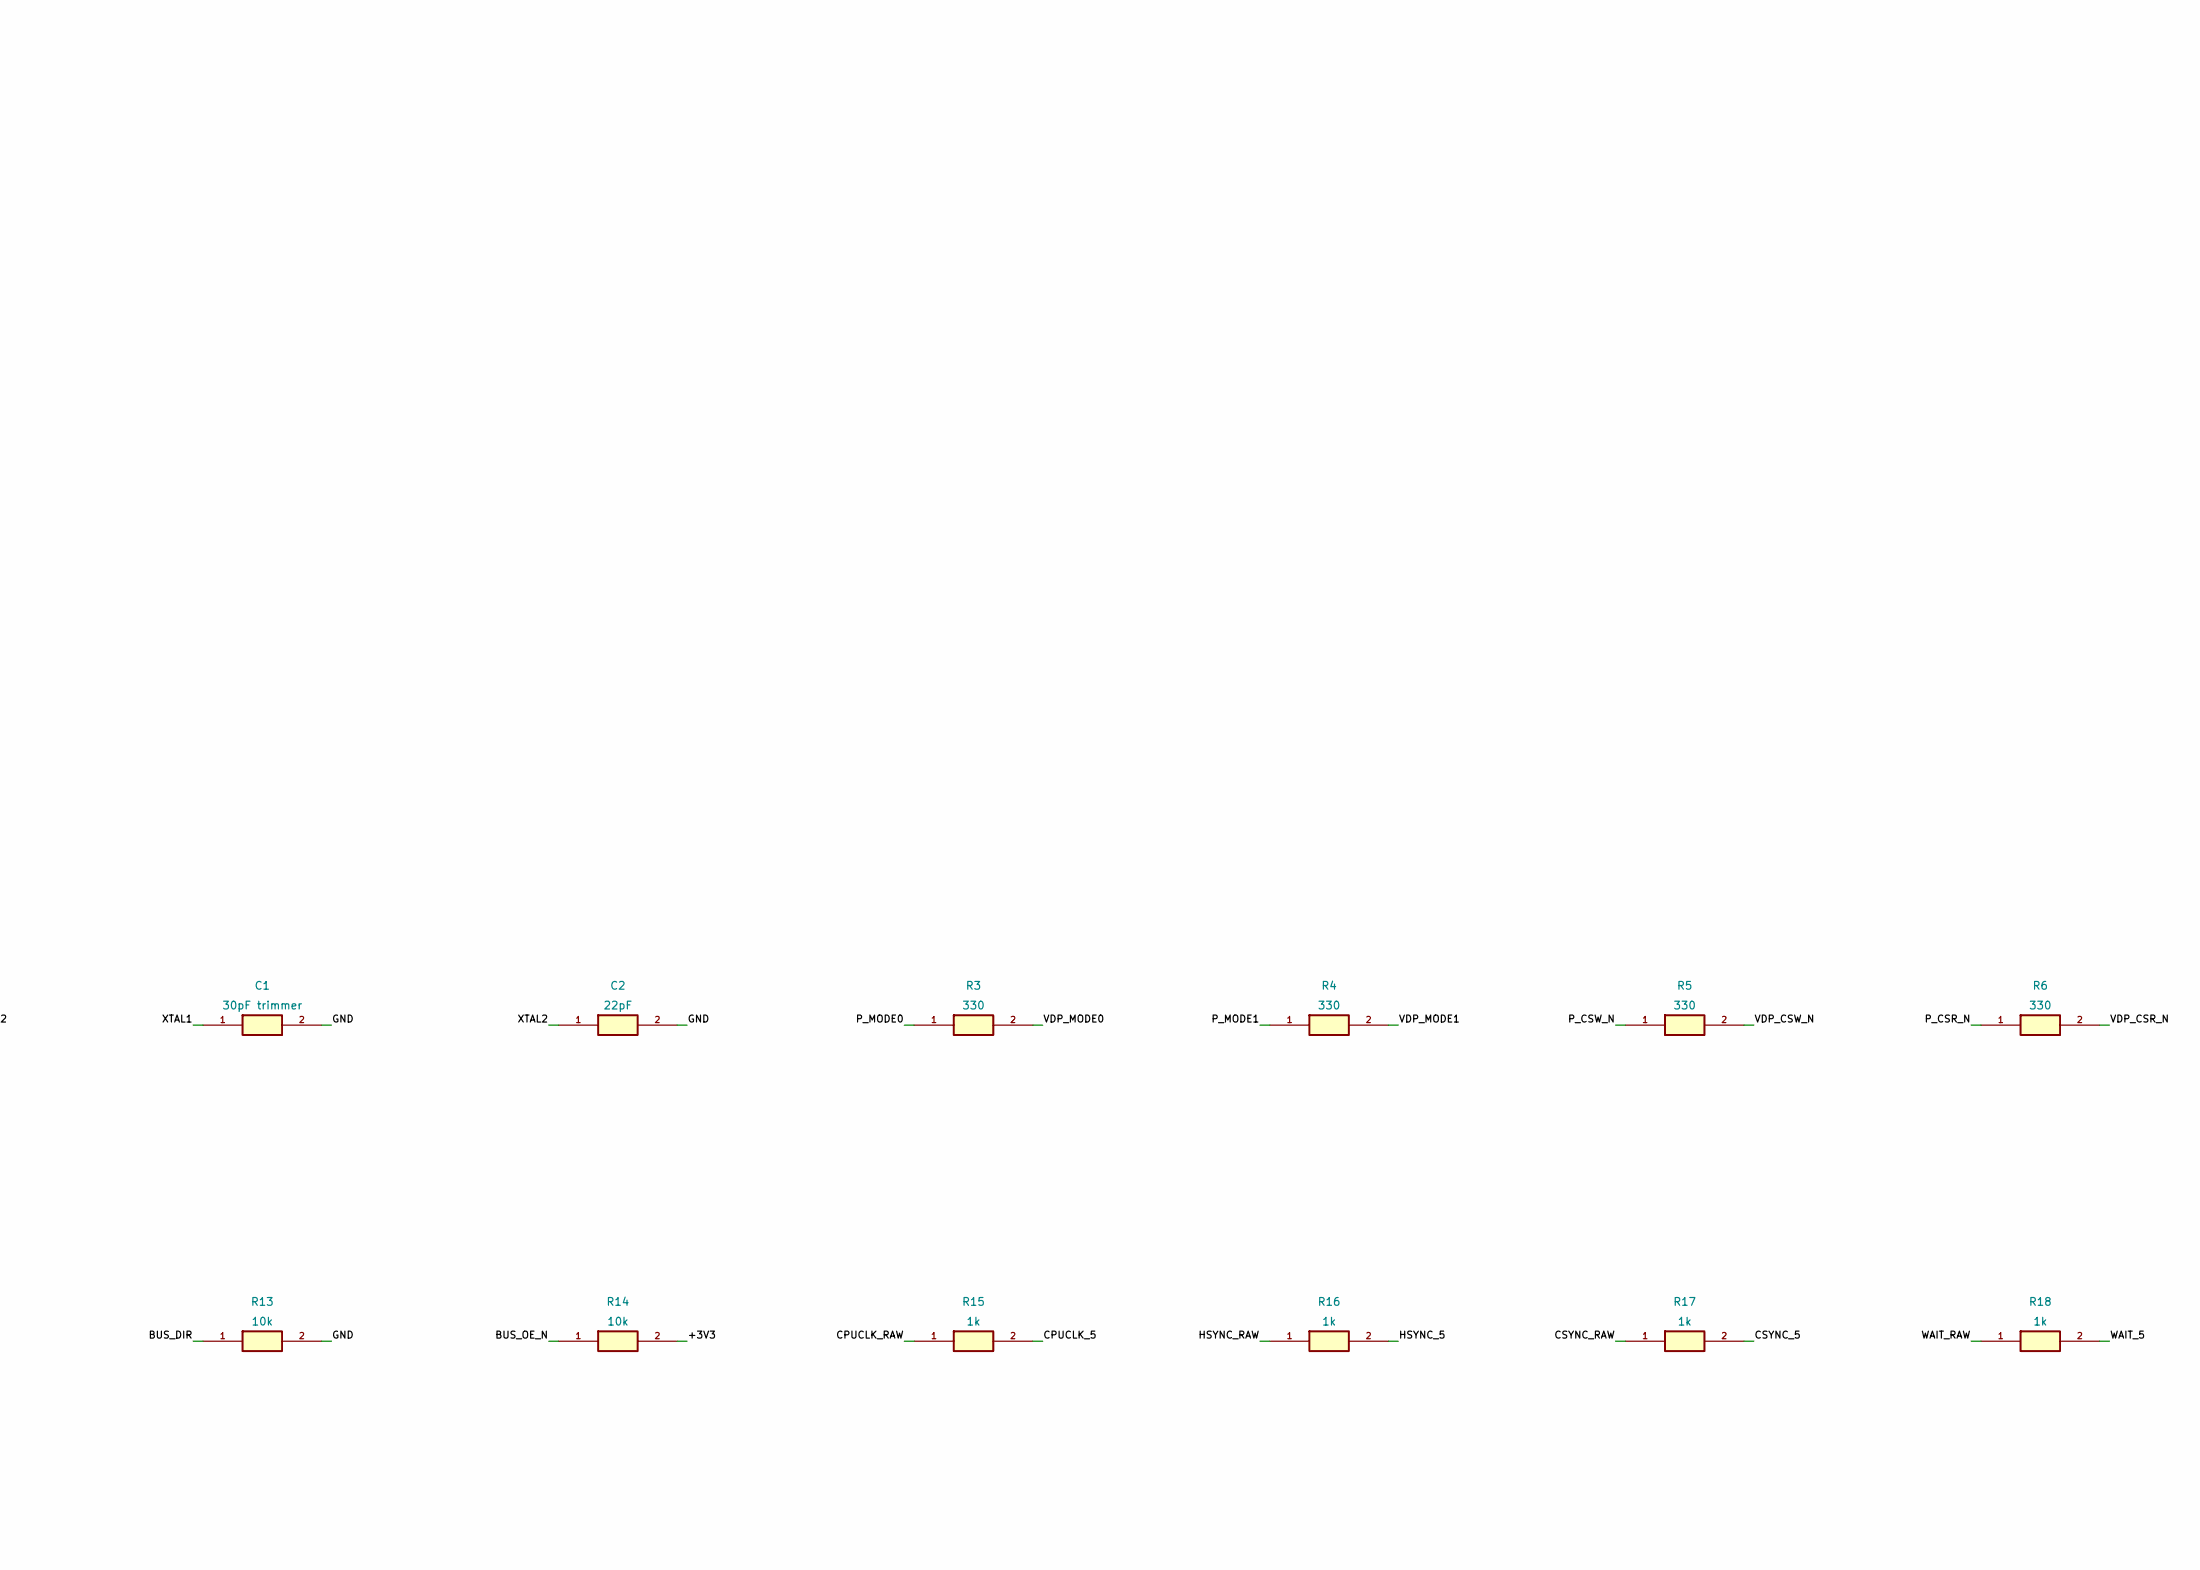
[picture p14: schematic V9958-Tester-RevB2-SRAM.kicad_sch, V9958 Pico Tester Revision B2 SRAM, part in row 1, column 2]

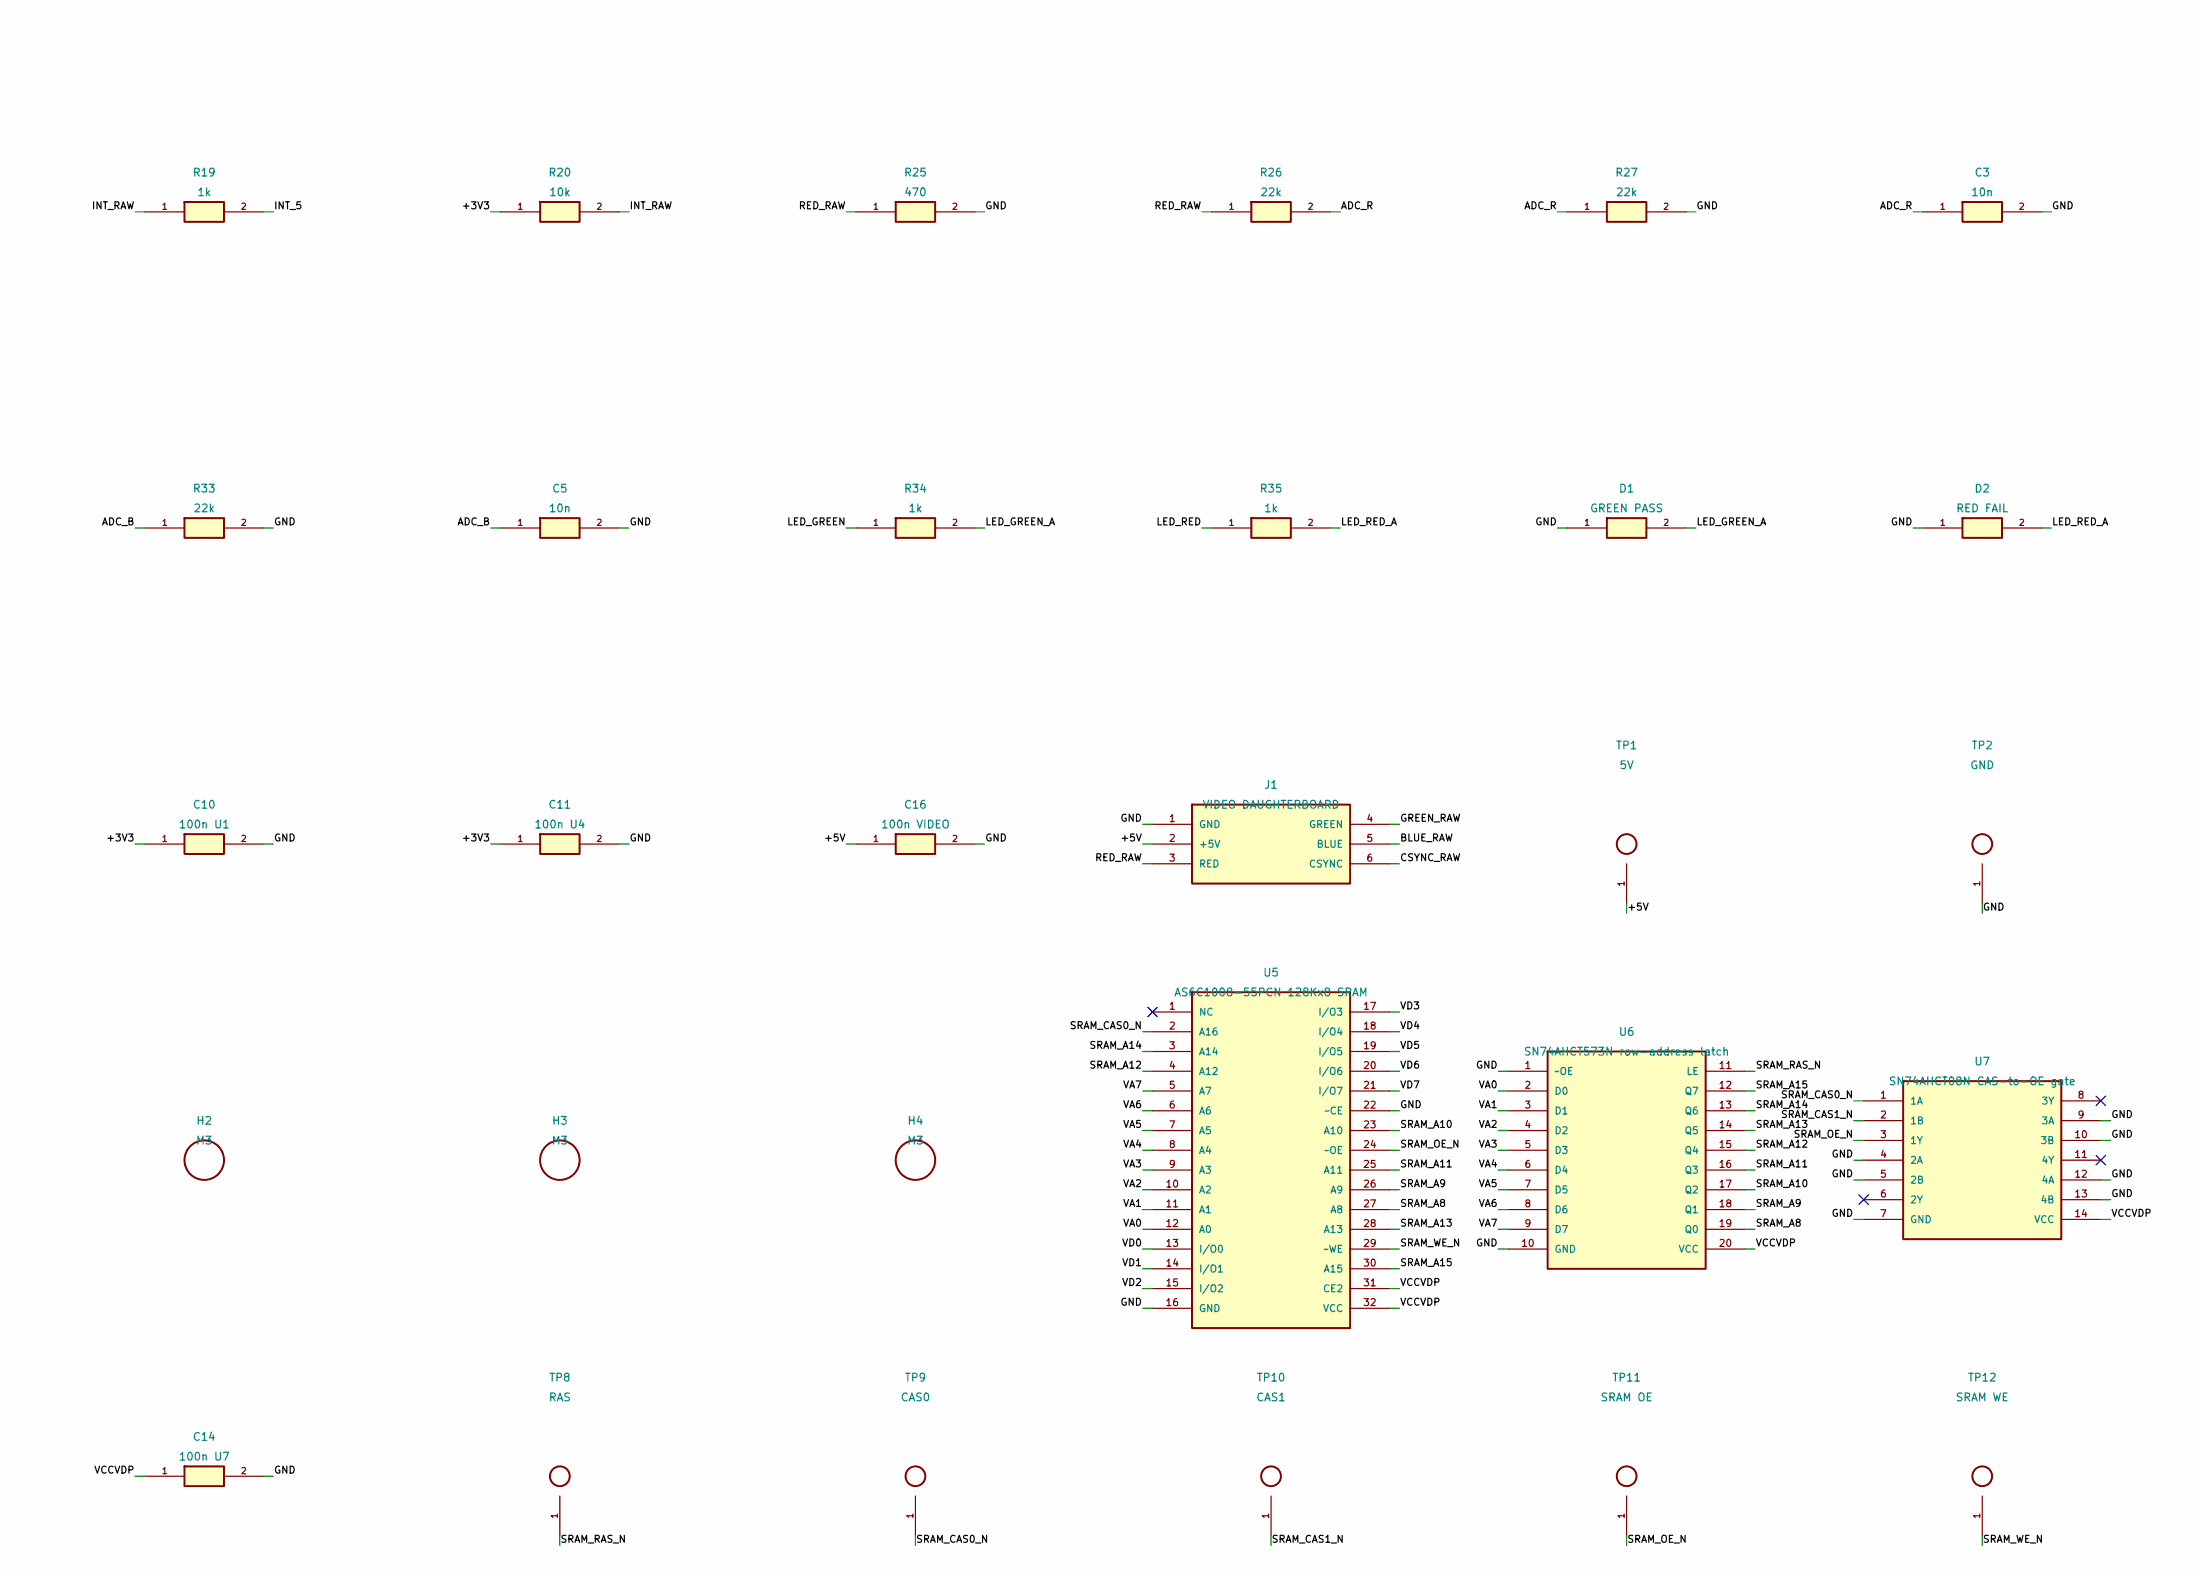
[picture p15: schematic V9958-Tester-RevB2-SRAM.kicad_sch, V9958 Pico Tester Revision B2 SRAM, part in row 2, column 1]

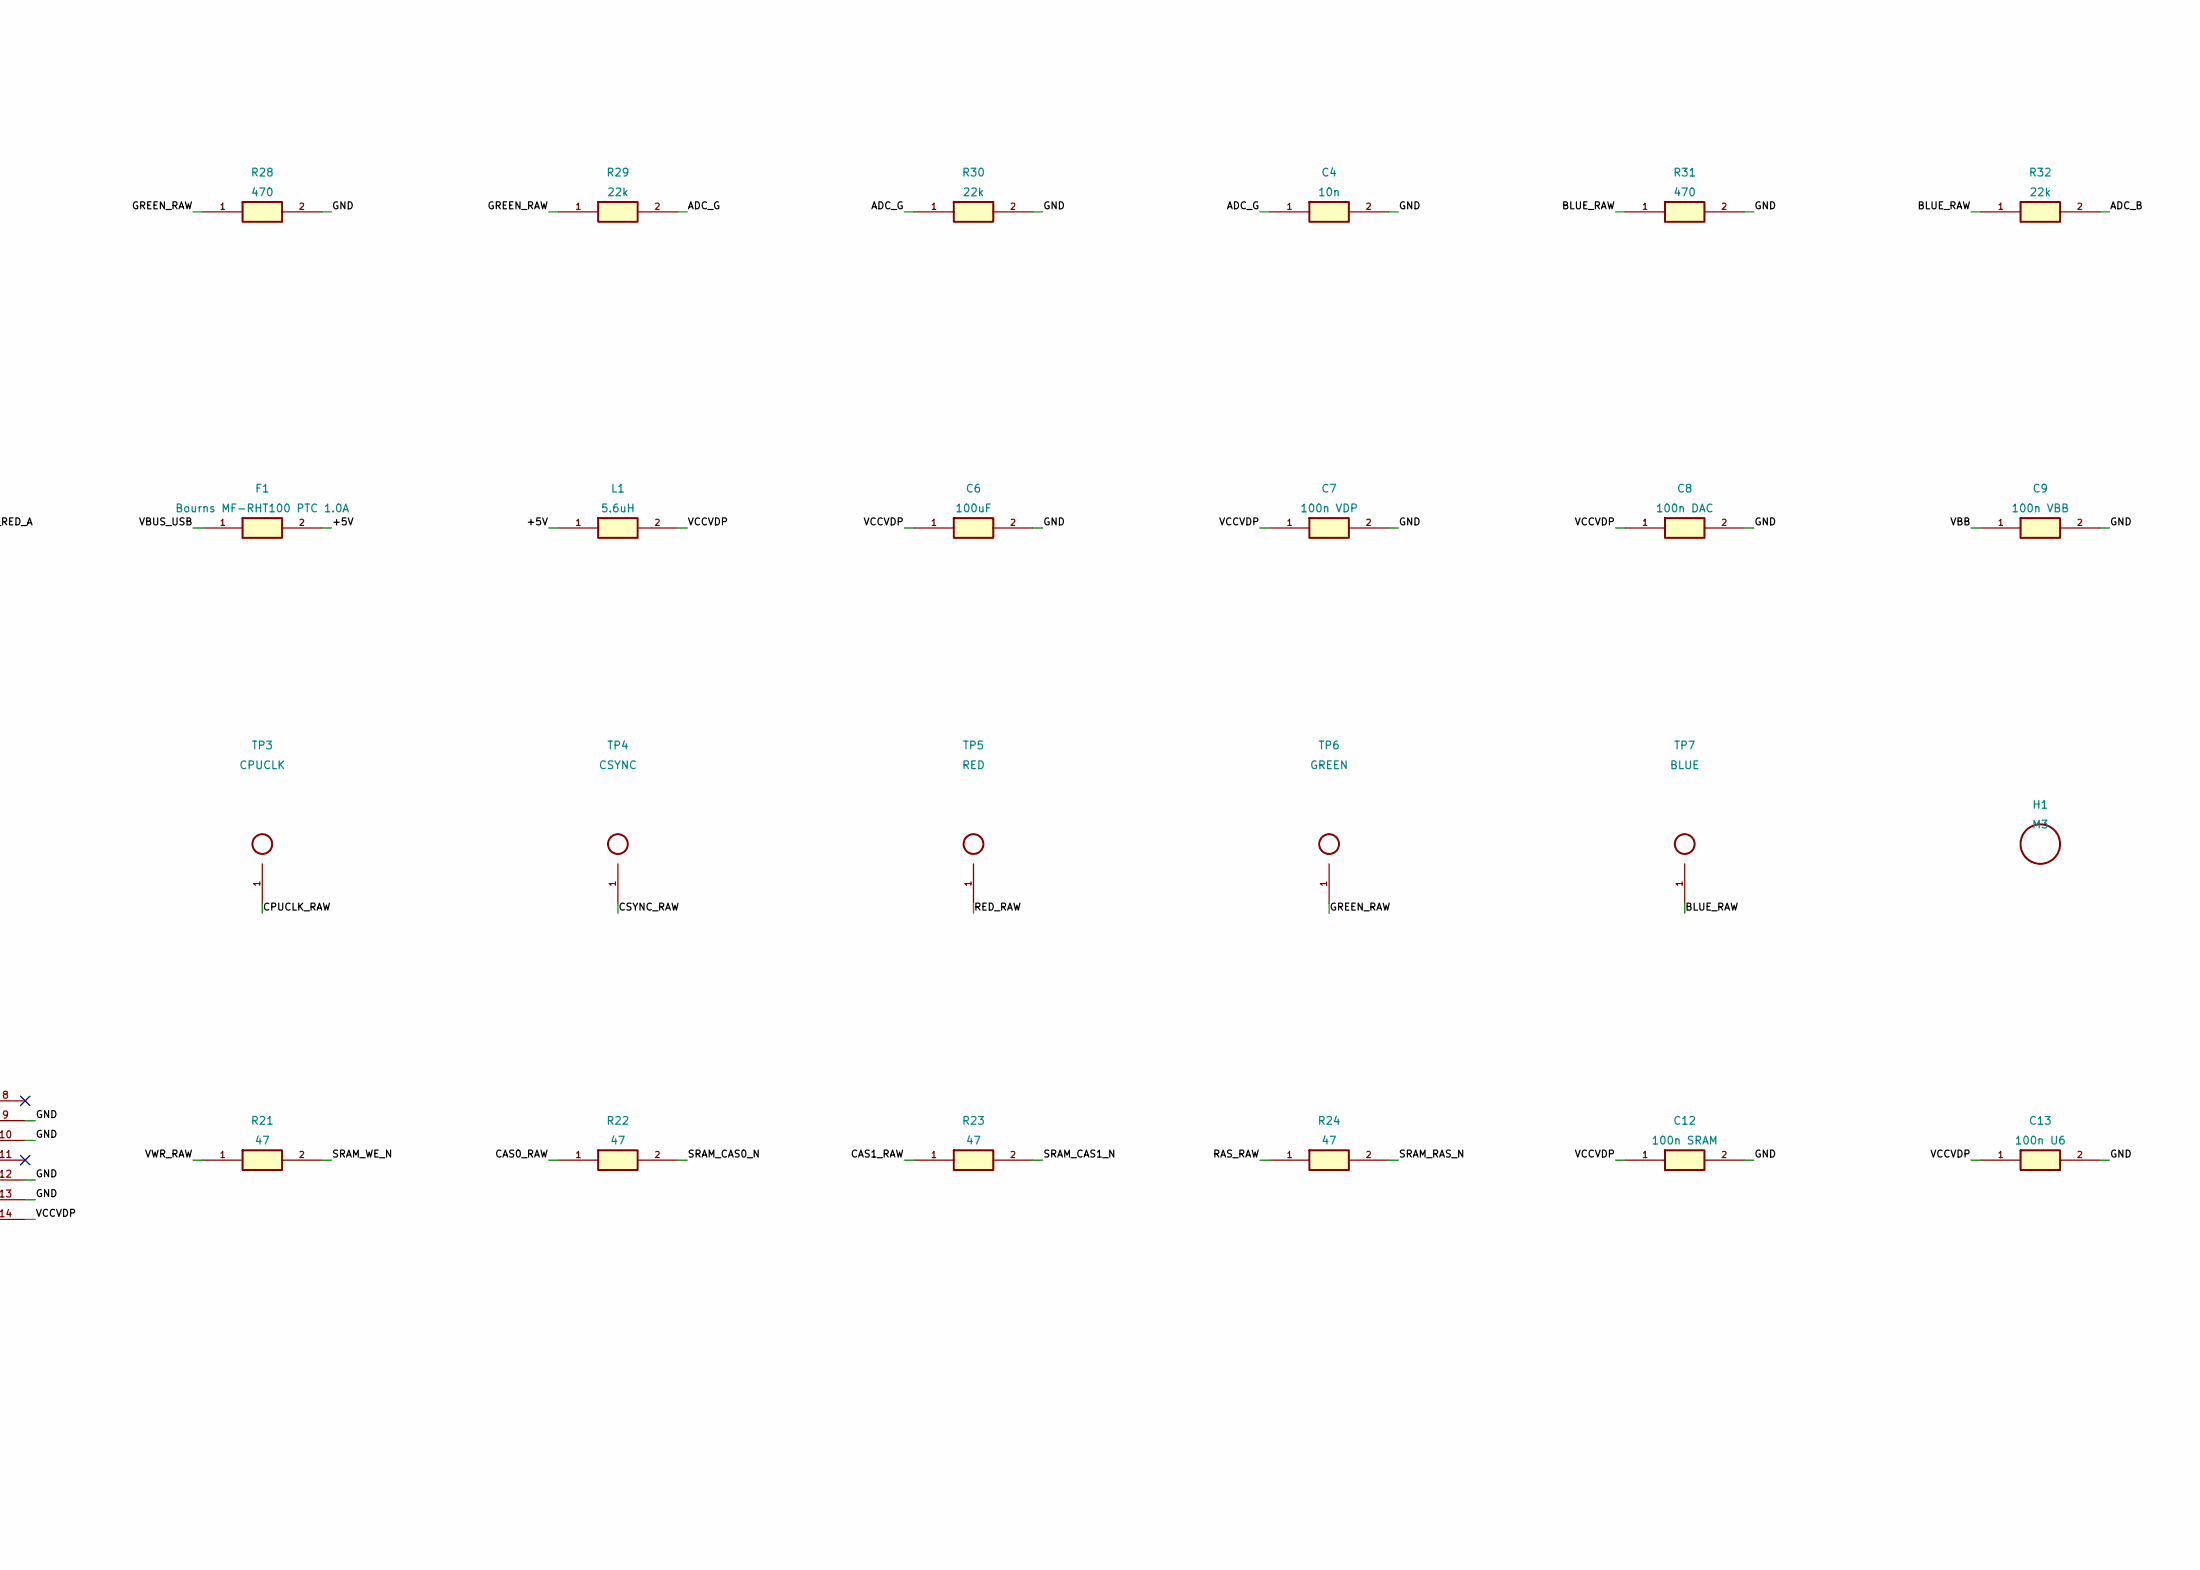
[picture p16: schematic V9958-Tester-RevB2-SRAM.kicad_sch, V9958 Pico Tester Revision B2 SRAM, part in row 2, column 2]

Parts:
A1: Raspberry Pi Pico; RaspberryPi_Pico_Common_THT
C1: 30pF trimmer; C_Trim_P5.00mm
C2: 22pF; C_Disc_D5.0mm_W2.5mm_P5.00mm
C3, C4, C5: 10n; C_Disc_D5.0mm_W2.5mm_P5.00mm
C6: 100uF; CP_Radial_D5.0mm_P2.00mm
C7: 100n VDP; C_Disc_D5.0mm_W2.5mm_P5.00mm
C8: 100n DAC; C_Disc_D5.0mm_W2.5mm_P5.00mm
C9: 100n VBB; C_Disc_D5.0mm_W2.5mm_P5.00mm
C10: 100n U1; C_Disc_D5.0mm_W2.5mm_P5.00mm
C11: 100n U4; C_Disc_D5.0mm_W2.5mm_P5.00mm
C12: 100n SRAM; C_Disc_D5.0mm_W2.5mm_P5.00mm
C13: 100n U6; C_Disc_D5.0mm_W2.5mm_P5.00mm
C14: 100n U7; C_Disc_D5.0mm_W2.5mm_P5.00mm
C16: 100n VIDEO; C_Disc_D5.0mm_W2.5mm_P5.00mm
D1: GREEN PASS; LED_D5.0mm
D2: RED FAIL; LED_D5.0mm
F1: Bourns MF-RHT100 PTC 1.0A; Fuse_Bourns_MF-RHT100
H1, H2, H3, H4: M3; MountingHole_3.2mm_M3
J1: VIDEO DAUGHTERBOARD; IDC-Header_2x03_P2.54mm_Vertical
L1: 5.6uH; L_Axial_L14.0mm_D4.5mm_P15.24mm_Horizontal_Fastron_LACC
R1, R8, R9, R10, R11, R12, R13, R14, R20: 10k; R_Axial_DIN0207_L6.3mm_D2.5mm_P7.62mm_Horizontal
R2: 470k; R_Axial_DIN0207_L6.3mm_D2.5mm_P7.62mm_Horizontal
R3, R4, R5, R6, R7: 330; R_Axial_DIN0207_L6.3mm_D2.5mm_P7.62mm_Horizontal
R15, R16, R17, R18, R19, R34, R35: 1k; R_Axial_DIN0207_L6.3mm_D2.5mm_P7.62mm_Horizontal
R21, R22, R23, R24: 47; R_Axial_DIN0207_L6.3mm_D2.5mm_P7.62mm_Horizontal
R25, R28, R31: 470; R_Axial_DIN0207_L6.3mm_D2.5mm_P7.62mm_Horizontal
R26, R27, R29, R30, R32, R33: 22k; R_Axial_DIN0207_L6.3mm_D2.5mm_P7.62mm_Horizontal
RN1: 10k bussed; R_Array_SIP10
TP1: 5V; TestPoint_THTPad_D2.0mm_Drill1.0mm
TP2: GND; TestPoint_THTPad_D2.0mm_Drill1.0mm
TP3: CPUCLK; TestPoint_THTPad_D2.0mm_Drill1.0mm
TP4: CSYNC; TestPoint_THTPad_D2.0mm_Drill1.0mm
TP5: RED; TestPoint_THTPad_D2.0mm_Drill1.0mm
TP6: GREEN; TestPoint_THTPad_D2.0mm_Drill1.0mm
TP7: BLUE; TestPoint_THTPad_D2.0mm_Drill1.0mm
TP8: RAS; TestPoint_THTPad_D2.0mm_Drill1.0mm
TP9: CAS0; TestPoint_THTPad_D2.0mm_Drill1.0mm
TP10: CAS1; TestPoint_THTPad_D2.0mm_Drill1.0mm
TP11: SRAM OE; TestPoint_THTPad_D2.0mm_Drill1.0mm
TP12: SRAM WE; TestPoint_THTPad_D2.0mm_Drill1.0mm
U1: SN74LVC245AN; DIP-20_W7.62mm_Socket_LongPads
U3: V9958 DUT; SDIP-64_W19.05mm_P1.778mm_Socket
U4: SN74LVC244AN; DIP-20_W7.62mm_Socket_LongPads
U5: AS6C1008-55PCN 128Kx8 SRAM; DIP-32_W15.24mm_Socket_LongPads
U6: SN74AHCT573N row-address latch; DIP-20_W7.62mm_Socket_LongPads
U7: SN74AHCT08N CAS-to-OE gate; DIP-14_W7.62mm_Socket_LongPads
Y1: 21.477270MHz; Crystal_HC49-U_Vertical

Connections:
/+3V3: A1.36 (3V3_OUT), C10.1, C11.1, R10.2, R11.2, R14.2, R20.1, U1.20 (VCC), U4.20 (VCC)
/+5V: C16.1, F1.2, J1.2 (+5V), L1.1, TP1.1
/ADC_B: A1.34 (GP28_ADC2), C5.1, R32.2, R33.1
/ADC_G: A1.32 (GP27_ADC1), C4.1, R29.2, R30.1
/ADC_R: A1.31 (GP26_ADC0), C3.1, R26.2, R27.1
/BLUE_RAW: J1.5 (BLUE), R31.1, R32.1, TP7.1, U3.24 (B)
/BUS_DIR: A1.16 (GP12), R13.1, U1.1 (DIR)
/BUS_OE_N: A1.17 (GP13), R14.1, U1.19 (~OE)
/CAS0_RAW: R22.1, U3.61 (~CAS0)
/CAS1_RAW: R23.1, U3.60 (~CAS1)
/CB0: RN1.2, U3.19 (C0)
/CB1: RN1.3, U3.18 (C1)
/CB2: RN1.4, U3.17 (C2)
/CB3: RN1.5, U3.16 (C3)
/CB4: RN1.6, U3.15 (C4)
/CB5: RN1.7, U3.14 (C5)
/CB6: RN1.8, U3.13 (C6)
/CB7: RN1.9, U3.12 (C7)
/CPUCLK_5: R15.2, U4.2 (1A1)
/CPUCLK_RAW: R15.1, TP3.1, U3.8 (CPUCLK/~VDS)
/CSYNC_5: R17.2, U4.6 (1A3)
/CSYNC_RAW: J1.6 (CSYNC), R17.1, TP4.1, U3.6 (~CSYNC)
/GND: A1.3 (GND), A1.8 (GND), A1.13 (GND), A1.18 (GND), A1.23 (GND), A1.28 (GND), A1.33 (AGND), A1.38 (GND), C1.2, C2.2, C3.2, C4.2, C5.2, C6.2, C7.2, C8.2, C9.2, C10.2, C11.2, C12.2, C13.2, C14.2, C16.2, D1.1, D2.1, J1.1 (GND), R8.2, R9.2, R12.2, R13.2, R25.2, R27.2, R28.2, R30.2, R31.2, R33.2, TP2.1, U1.10 (GND), U3.1 (GND), U3.20 (GND_DAC), U4.1 (~1OE), U4.10 (GND), U4.13 (2A2), U4.15 (2A3), U4.17 (2A4), U4.19 (~2OE), U5.16 (GND), U5.22 (~CE), U6.1 (~OE), U6.10 (GND), U7.4 (2A), U7.5 (2B), U7.7 (GND), U7.9 (3A), U7.10 (3B), U7.12 (4A), U7.13 (4B)
/GREEN_RAW: J1.4 (GREEN), R28.1, R29.1, TP6.1, U3.22 (G)
/HRESET: R1.2, U3.27 (~HRESET)
/HSYNC_5: R16.2, U4.4 (1A2)
/HSYNC_RAW: R16.1, U3.5 (~HSYNC)
/INT_5: R19.2, U4.11 (2A1)
/INT_RAW: R19.1, R20.2, U3.25 (~INT)
/LED_GREEN: A1.20 (GP15), R34.1
/LED_GREEN_A: D1.2, R34.2
/LED_RED: A1.21 (GP16), R35.1
/LED_RED_A: D2.2, R35.2
/MON_CPUCLK: A1.22 (GP17), U4.18 (1Y1)
/MON_CSYNC: A1.27 (GP21), U4.14 (1Y3)
/MON_HSYNC: A1.25 (GP19), U4.16 (1Y2)
/MON_INT: A1.26 (GP20), U4.9 (2Y1)
/MON_WAIT: A1.24 (GP18), U4.12 (1Y4)
/P_CSR_N: A1.15 (GP11), R6.1
/P_CSW_N: A1.14 (GP10), R5.1
/P_D0: A1.1 (GP0), U1.2 (A0)
/P_D1: A1.2 (GP1), U1.3 (A1)
/P_D2: A1.4 (GP2), U1.4 (A2)
/P_D3: A1.5 (GP3), U1.5 (A3)
/P_D4: A1.6 (GP4), U1.6 (A4)
/P_D5: A1.7 (GP5), U1.7 (A5)
/P_D6: A1.9 (GP6), U1.8 (A6)
/P_D7: A1.10 (GP7), U1.9 (A7)
/P_MODE0: A1.11 (GP8), R3.1
/P_MODE1: A1.12 (GP9), R4.1
/P_RESET_N: A1.19 (GP14), R7.1
/RAS_RAW: R24.1, U3.62 (~RAS)
/RED_RAW: J1.3 (RED), R25.1, R26.1, TP5.1, U3.23 (R)
/SRAM_A8: U5.27 (A8), U6.19 (Q0)
/SRAM_A9: U5.26 (A9), U6.18 (Q1)
/SRAM_A10: U5.23 (A10), U6.17 (Q2)
/SRAM_A11: U5.25 (A11), U6.16 (Q3)
/SRAM_A12: U5.4 (A12), U6.15 (Q4)
/SRAM_A13: U5.28 (A13), U6.14 (Q5)
/SRAM_A14: U5.3 (A14), U6.13 (Q6)
/SRAM_A15: U5.30 (A15), U6.12 (Q7)
/SRAM_CAS0_N: R22.2, TP9.1, U5.2 (A16), U7.1 (1A)
/SRAM_CAS1_N: R23.2, TP10.1, U7.2 (1B)
/SRAM_OE_N: TP11.1, U5.24 (~OE), U7.3 (1Y)
/SRAM_RAS_N: R24.2, TP8.1, U6.11 (LE)
/SRAM_WE_N: R21.2, TP12.1, U5.29 (~WE)
/VA0: U3.49 (AD0), U5.12 (A0), U6.2 (D0)
/VA1: U3.50 (AD1), U5.11 (A1), U6.3 (D1)
/VA2: U3.51 (AD2), U5.10 (A2), U6.4 (D2)
/VA3: U3.52 (AD3), U5.9 (A3), U6.5 (D3)
/VA4: U3.53 (AD4), U5.8 (A4), U6.6 (D4)
/VA5: U3.54 (AD5), U5.7 (A5), U6.7 (D5)
/VA6: U3.55 (AD6), U5.6 (A6), U6.8 (D6)
/VA7: U3.56 (AD7), U5.5 (A7), U6.9 (D7)
/VBB: C9.1, U3.33 (VBB)
/VBUS_USB: A1.40 (VBUS), F1.1
/VCCVDP: C6.1, C7.1, C8.1, C12.1, C13.1, C14.1, L1.2, R1.1, RN1.1 (COM), U3.21 (VDD_DAC), U3.58 (VDD), U5.31 (CE2), U5.32 (VCC), U6.20 (VCC), U7.14 (VCC)
/VD0: U3.41 (RD0), U5.13 (I/O0)
/VD1: U3.42 (RD1), U5.14 (I/O1)
/VD2: U3.43 (RD2), U5.15 (I/O2)
/VD3: U3.44 (RD3), U5.17 (I/O3)
/VD4: U3.45 (RD4), U5.18 (I/O4)
/VD5: U3.46 (RD5), U5.19 (I/O5)
/VD6: U3.47 (RD6), U5.20 (I/O6)
/VD7: U3.48 (RD7), U5.21 (I/O7)
/VDP_CSR_N: R6.2, R11.1, U3.31 (~CSR)
/VDP_CSW_N: R5.2, R10.1, U3.30 (~CSW)
/VDP_D0: U1.18 (B0), U3.40 (CD0)
/VDP_D1: U1.17 (B1), U3.39 (CD1)
/VDP_D2: U1.16 (B2), U3.38 (CD2)
/VDP_D3: U1.15 (B3), U3.37 (CD3)
/VDP_D4: U1.14 (B4), U3.36 (CD4)
/VDP_D5: U1.13 (B5), U3.35 (CD5)
/VDP_D6: U1.12 (B6), U3.34 (CD6)
/VDP_D7: U1.11 (B7), U3.32 (CD7)
/VDP_MODE0: R3.2, R8.1, U3.29 (MODE0)
/VDP_MODE1: R4.2, R9.1, U3.28 (MODE1)
/VDP_RESET_N: R7.2, R12.1, U3.9 (~RESET)
/VRESET: RN1.10, U3.4 (~VRESET)
/VWR_RAW: R21.1, U3.57 (R/~W)
/WAIT_5: R18.2, U4.8 (1A4)
/WAIT_RAW: R18.1, U3.26 (~WAIT)
/XTAL1: C1.1, R2.1, U3.63 (XTAL1), Y1.1
/XTAL2: C2.1, R2.2, U3.64 (XTAL2), Y1.2

Notes on the sheet:
V9958 Pico Tester Revision B2 SRAM - B2 PROTOTYPE
All carrier-board parts are through-hole.
Power off before inserting or removing socketed ICs.
Prototype/unvalidated: verify mechanical fit and electrical levels before relying on results.

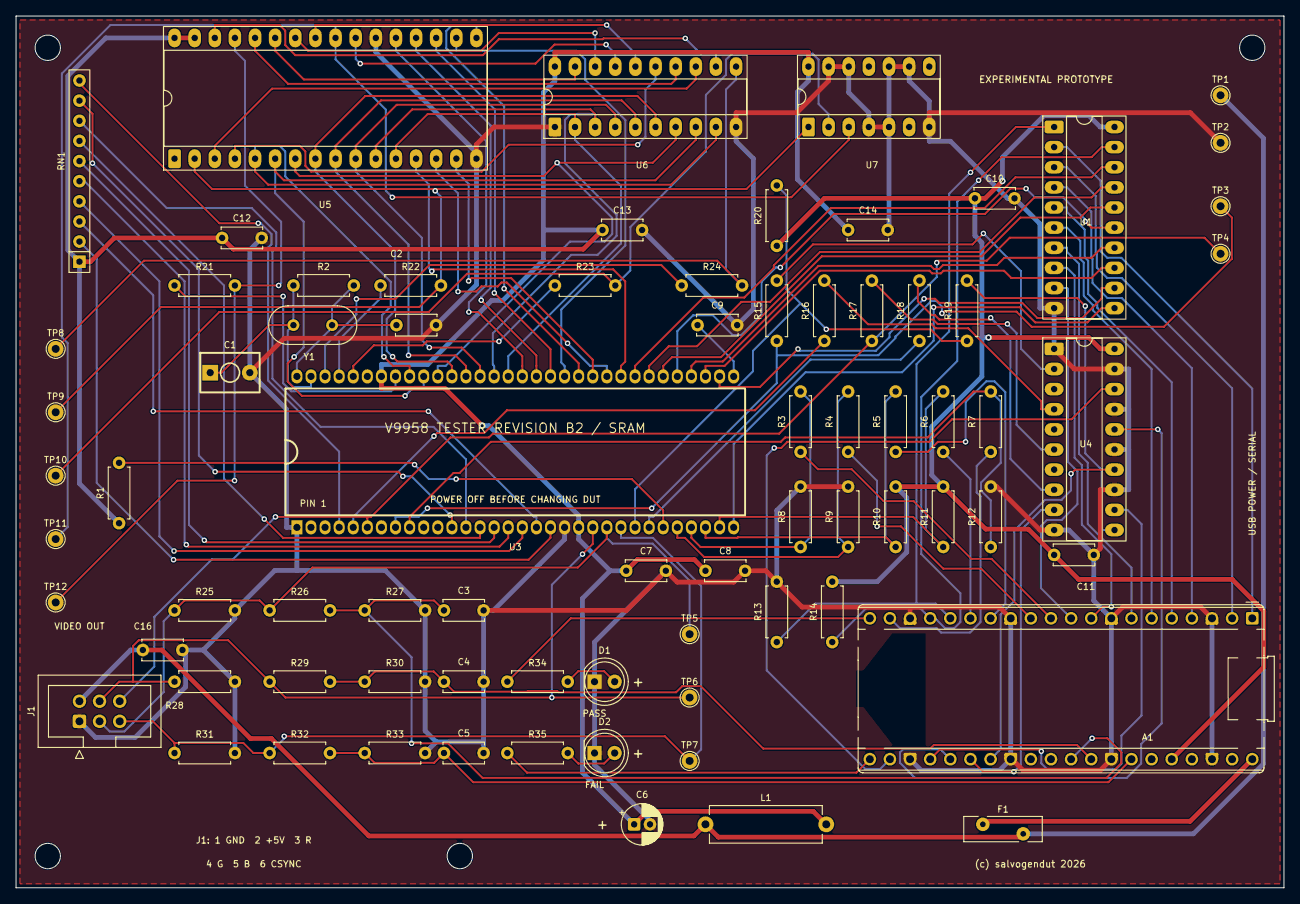
[picture p17: board V9958-Tester-RevB2-SRAM.kicad_pcb from above]

Board: 2 copper layers, 160.0 x 110.0 mm, 80 parts (0 on the bottom side), 104 nets.
