salvogendut/V9958-tester/video-daughterboard/V9958-Video-Daughterboard.kicad_pcb

## KiCad design video-daughterboard/V9958-Video-Daughterboard.kicad_pcb (2026-11-06)

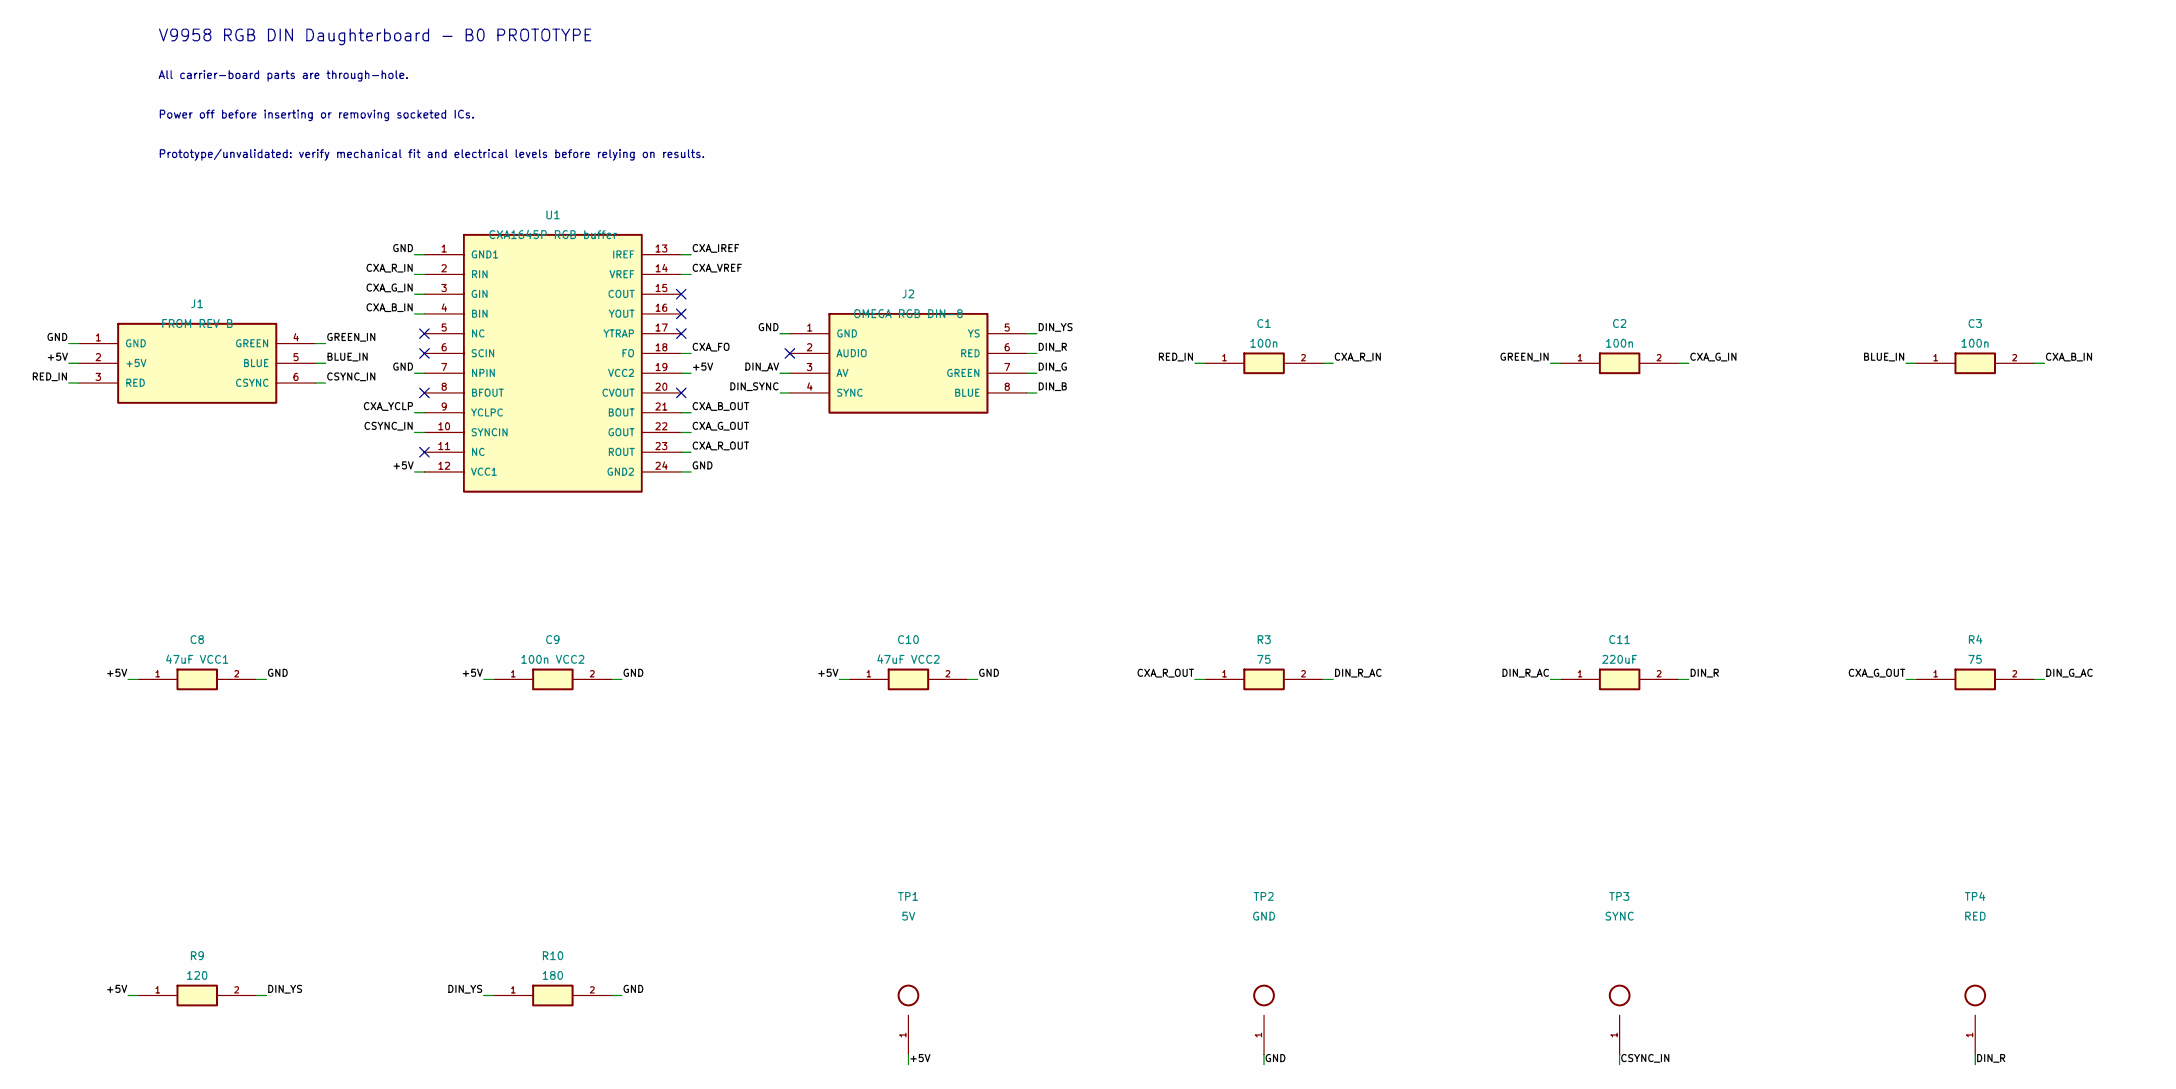
[picture p18: schematic V9958-Video-Daughterboard.kicad_sch, V9958 RGB DIN Daughterboard, part in row 1, column 1]

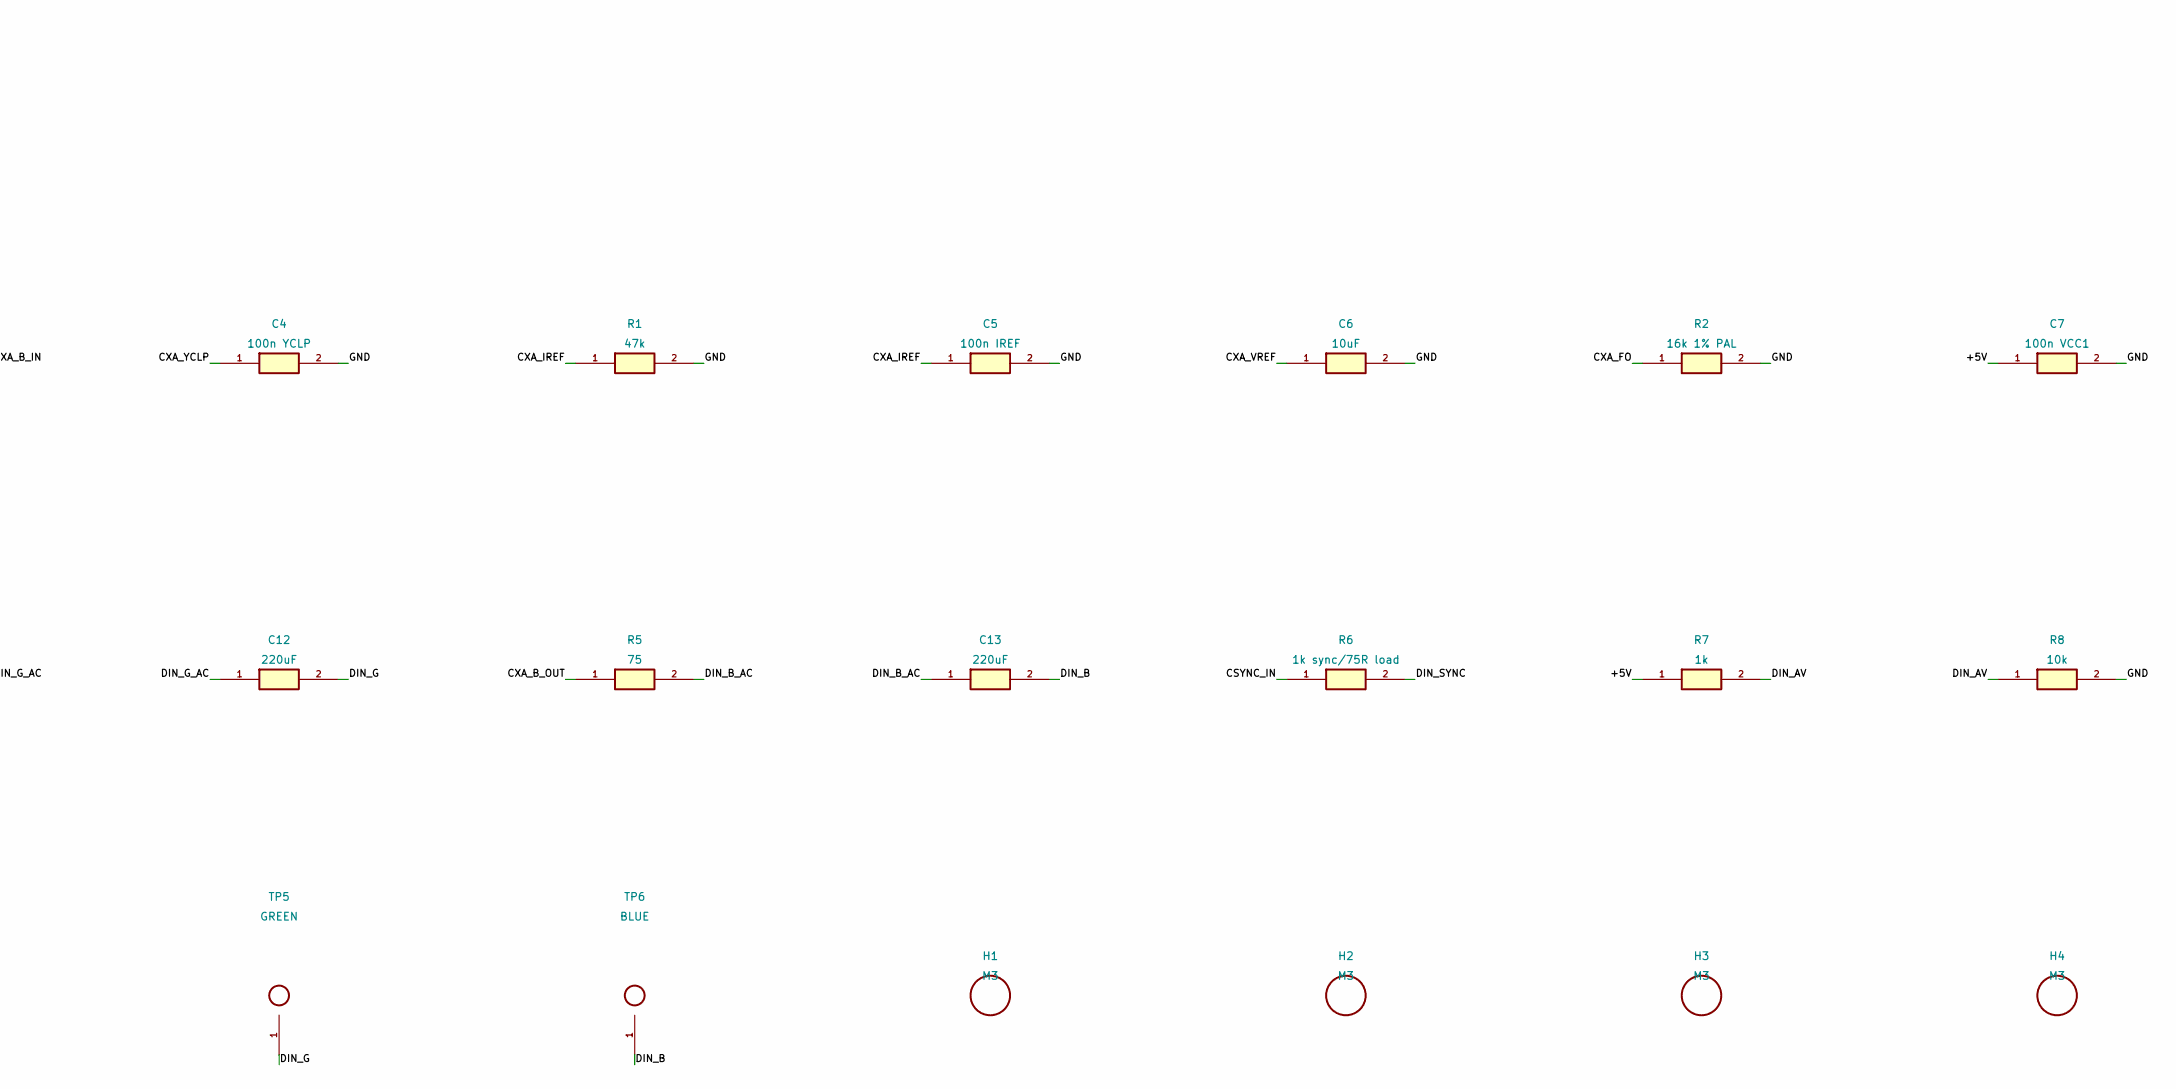
[picture p19: schematic V9958-Video-Daughterboard.kicad_sch, V9958 RGB DIN Daughterboard, part in row 1, column 2]

Parts:
C1, C2, C3: 100n; C_Disc_D5.0mm_W2.5mm_P5.00mm
C4: 100n YCLP; C_Disc_D5.0mm_W2.5mm_P5.00mm
C5: 100n IREF; C_Disc_D5.0mm_W2.5mm_P5.00mm
C6: 10uF; CP_Radial_D5.0mm_P2.00mm
C7: 100n VCC1; C_Disc_D5.0mm_W2.5mm_P5.00mm
C8: 47uF VCC1; CP_Radial_D5.0mm_P2.00mm
C9: 100n VCC2; C_Disc_D5.0mm_W2.5mm_P5.00mm
C10: 47uF VCC2; CP_Radial_D5.0mm_P2.00mm
C11, C12, C13: 220uF; CP_Radial_D8.0mm_P3.50mm
H1, H2, H3, H4: M3; MountingHole_3.2mm_M3
J1: FROM REV B; IDC-Header_2x03_P2.54mm_Vertical
J2: OMEGA RGB DIN-8; DIN8_Omega_THT
R1: 47k; R_Axial_DIN0207_L6.3mm_D2.5mm_P7.62mm_Horizontal
R2: 16k 1% PAL; R_Axial_DIN0207_L6.3mm_D2.5mm_P7.62mm_Horizontal
R3, R4, R5: 75; R_Axial_DIN0207_L6.3mm_D2.5mm_P7.62mm_Horizontal
R6: 1k sync/75R load; R_Axial_DIN0207_L6.3mm_D2.5mm_P7.62mm_Horizontal
R7: 1k; R_Axial_DIN0207_L6.3mm_D2.5mm_P7.62mm_Horizontal
R8: 10k; R_Axial_DIN0207_L6.3mm_D2.5mm_P7.62mm_Horizontal
R9: 120; R_Axial_DIN0207_L6.3mm_D2.5mm_P7.62mm_Horizontal
R10: 180; R_Axial_DIN0207_L6.3mm_D2.5mm_P7.62mm_Horizontal
TP1: 5V; TestPoint_THTPad_D2.0mm_Drill1.0mm
TP2: GND; TestPoint_THTPad_D2.0mm_Drill1.0mm
TP3: SYNC; TestPoint_THTPad_D2.0mm_Drill1.0mm
TP4: RED; TestPoint_THTPad_D2.0mm_Drill1.0mm
TP5: GREEN; TestPoint_THTPad_D2.0mm_Drill1.0mm
TP6: BLUE; TestPoint_THTPad_D2.0mm_Drill1.0mm
U1: CXA1645P RGB buffer; DIP-24_W10.16mm_Socket_LongPads

Connections:
/+5V: C7.1, C8.1, C9.1, C10.1, J1.2 (+5V), R7.1, R9.1, TP1.1, U1.12 (VCC1), U1.19 (VCC2)
/BLUE_IN: C3.1, J1.5 (BLUE)
/CSYNC_IN: J1.6 (CSYNC), R6.1, TP3.1, U1.10 (SYNCIN)
/CXA_B_IN: C3.2, U1.4 (BIN)
/CXA_B_OUT: R5.1, U1.21 (BOUT)
/CXA_FO: R2.1, U1.18 (FO)
/CXA_G_IN: C2.2, U1.3 (GIN)
/CXA_G_OUT: R4.1, U1.22 (GOUT)
/CXA_IREF: C5.1, R1.1, U1.13 (IREF)
/CXA_R_IN: C1.2, U1.2 (RIN)
/CXA_R_OUT: R3.1, U1.23 (ROUT)
/CXA_VREF: C6.1, U1.14 (VREF)
/CXA_YCLP: C4.1, U1.9 (YCLPC)
/DIN_AV: J2.3 (AV), R7.2, R8.1
/DIN_B: C13.2, J2.8 (BLUE), TP6.1
/DIN_B_AC: C13.1, R5.2
/DIN_G: C12.2, J2.7 (GREEN), TP5.1
/DIN_G_AC: C12.1, R4.2
/DIN_R: C11.2, J2.6 (RED), TP4.1
/DIN_R_AC: C11.1, R3.2
/DIN_SYNC: J2.4 (SYNC), R6.2
/DIN_YS: J2.5 (YS), R9.2, R10.1
/GND: C4.2, C5.2, C6.2, C7.2, C8.2, C9.2, C10.2, J1.1 (GND), J2.1 (GND), R1.2, R2.2, R8.2, R10.2, TP2.1, U1.1 (GND1), U1.7 (NPIN), U1.24 (GND2)
/GREEN_IN: C2.1, J1.4 (GREEN)
/RED_IN: C1.1, J1.3 (RED)

Notes on the sheet:
V9958 RGB DIN Daughterboard - B0 PROTOTYPE
All carrier-board parts are through-hole.
Power off before inserting or removing socketed ICs.
Prototype/unvalidated: verify mechanical fit and electrical levels before relying on results.

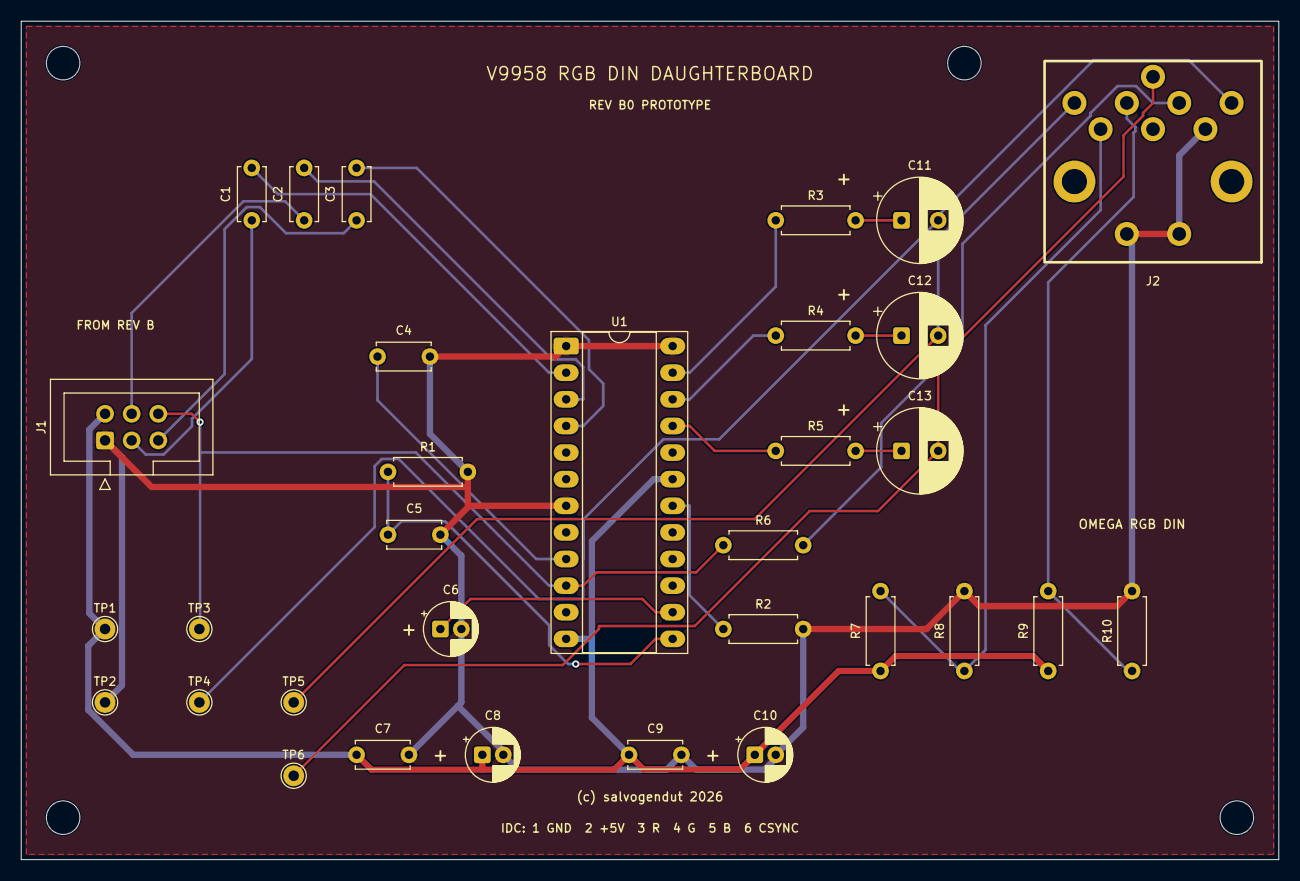
[picture p20: board V9958-Video-Daughterboard.kicad_pcb from above]

Board: 2 copper layers, 120.0 x 80.0 mm, 36 parts (0 on the bottom side), 25 nets.
