salvogendut/V9958-tester/V9958-Tester.kicad_pcb

## KiCad design V9958-Tester.kicad_pcb (2026-11-06)

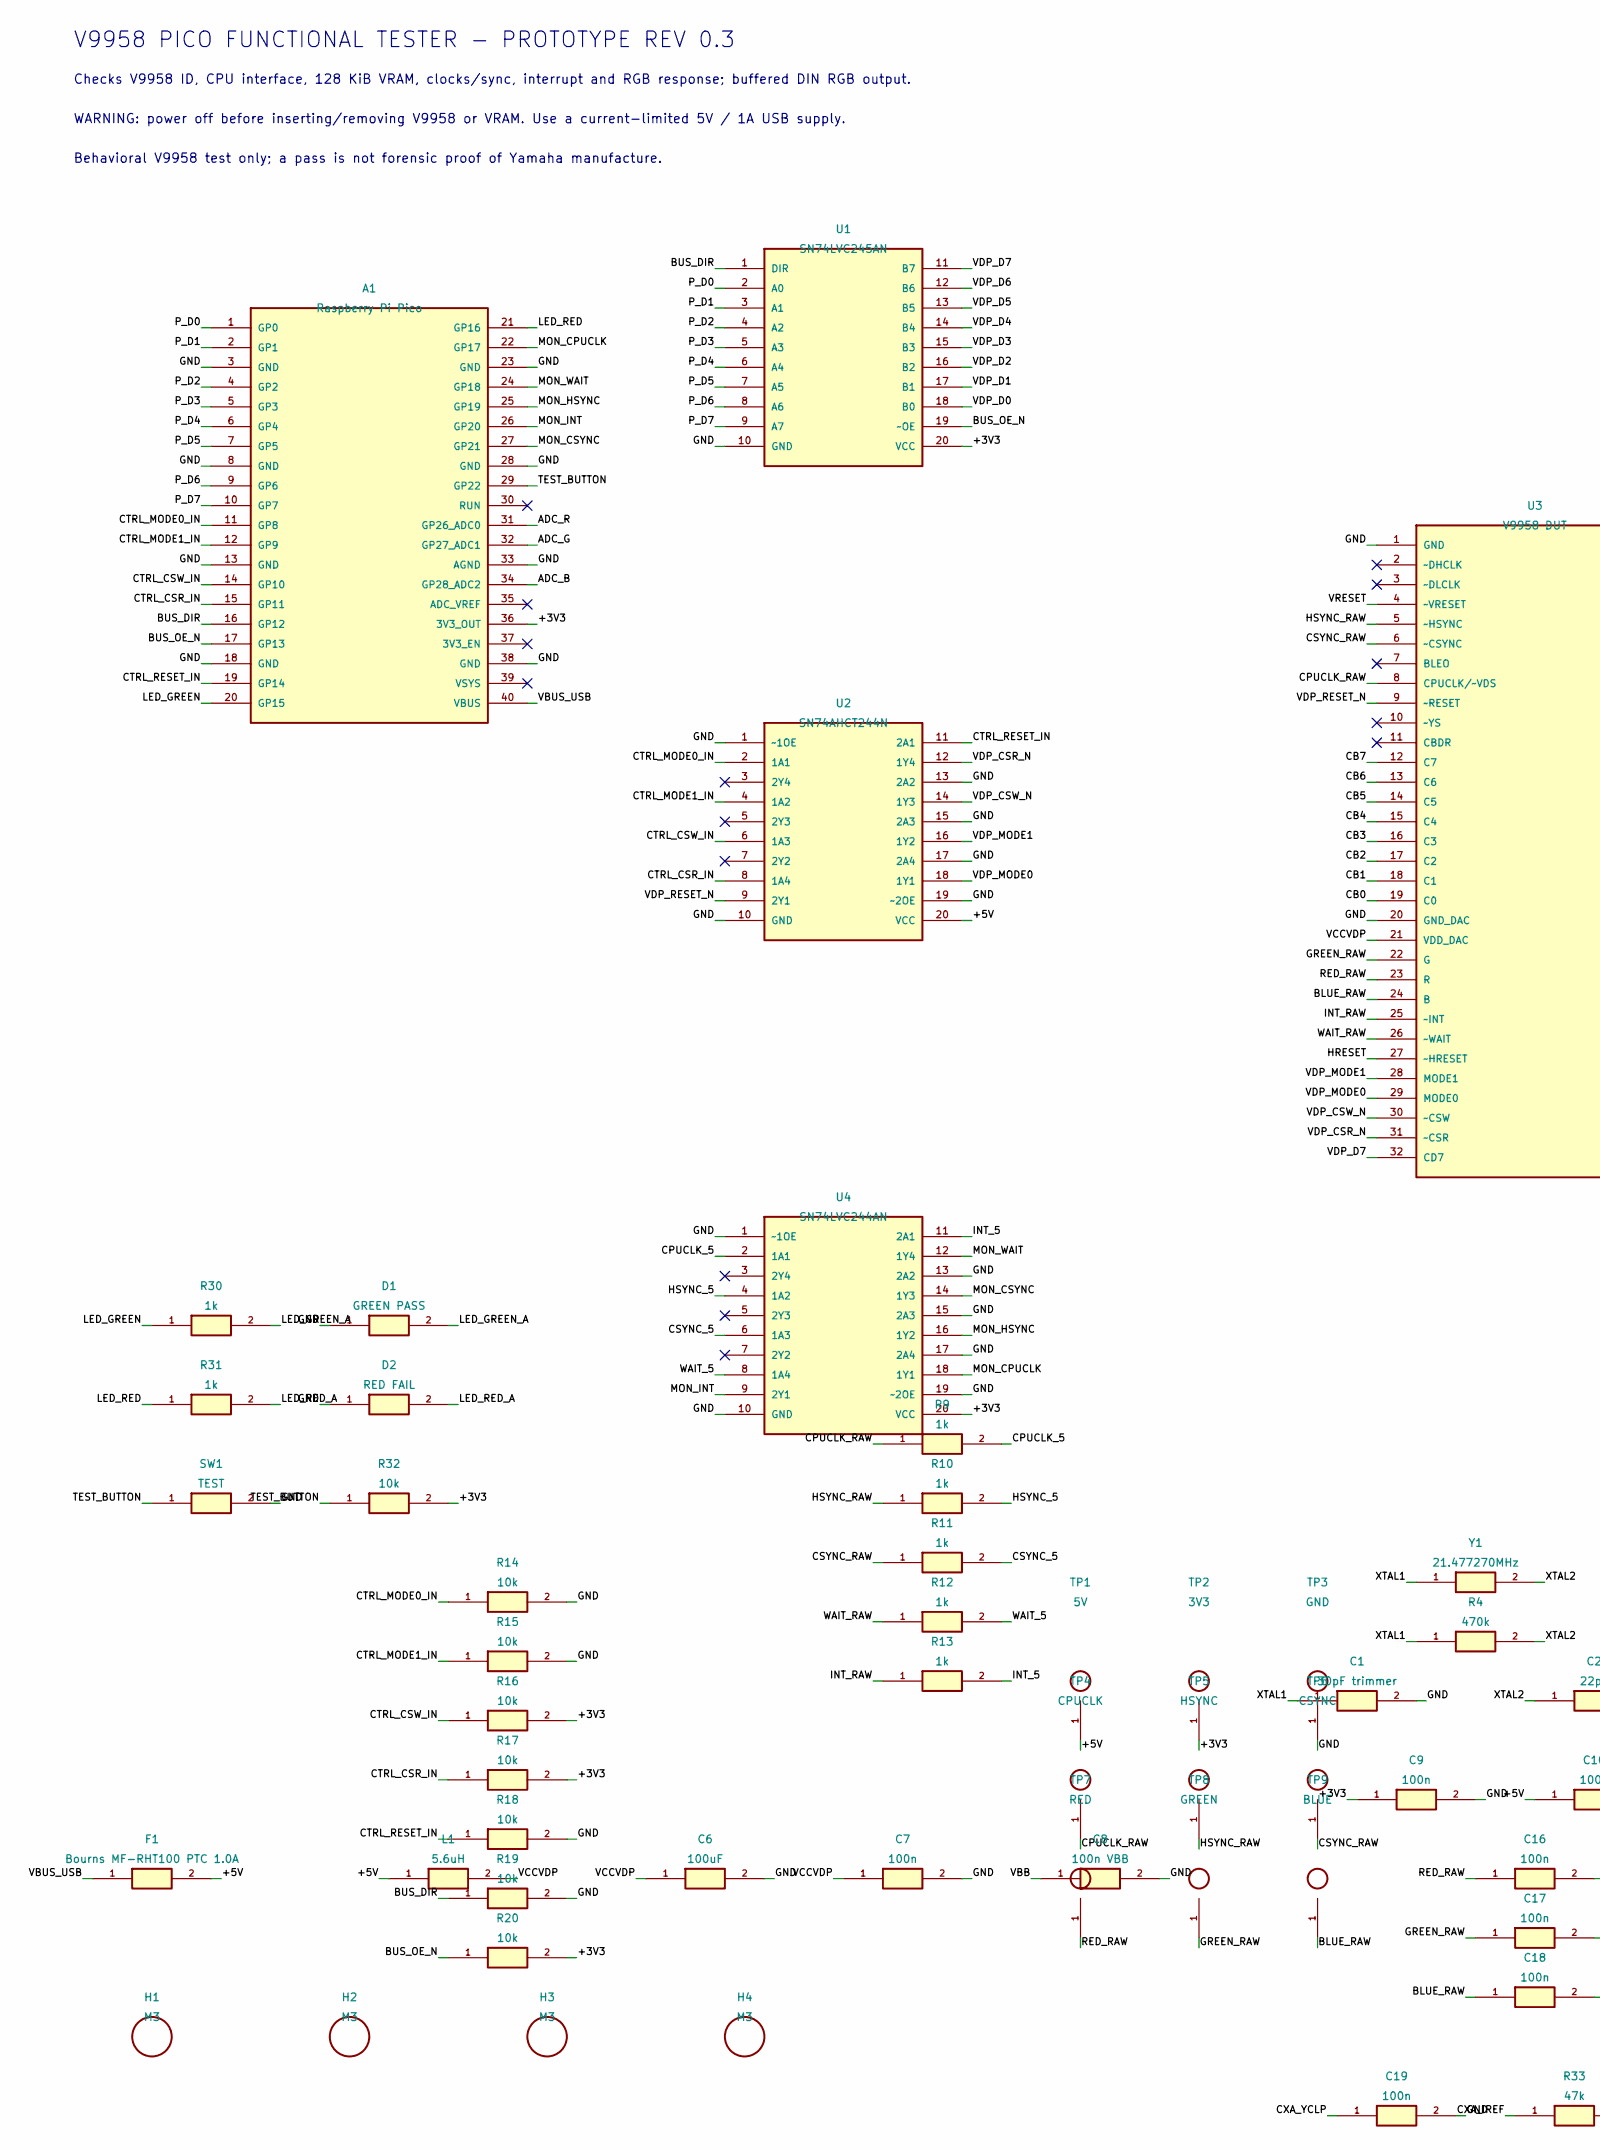
[picture p21: schematic V9958-Tester.kicad_sch, V9958 Pico Functional Tester, part in row 1, column 1]

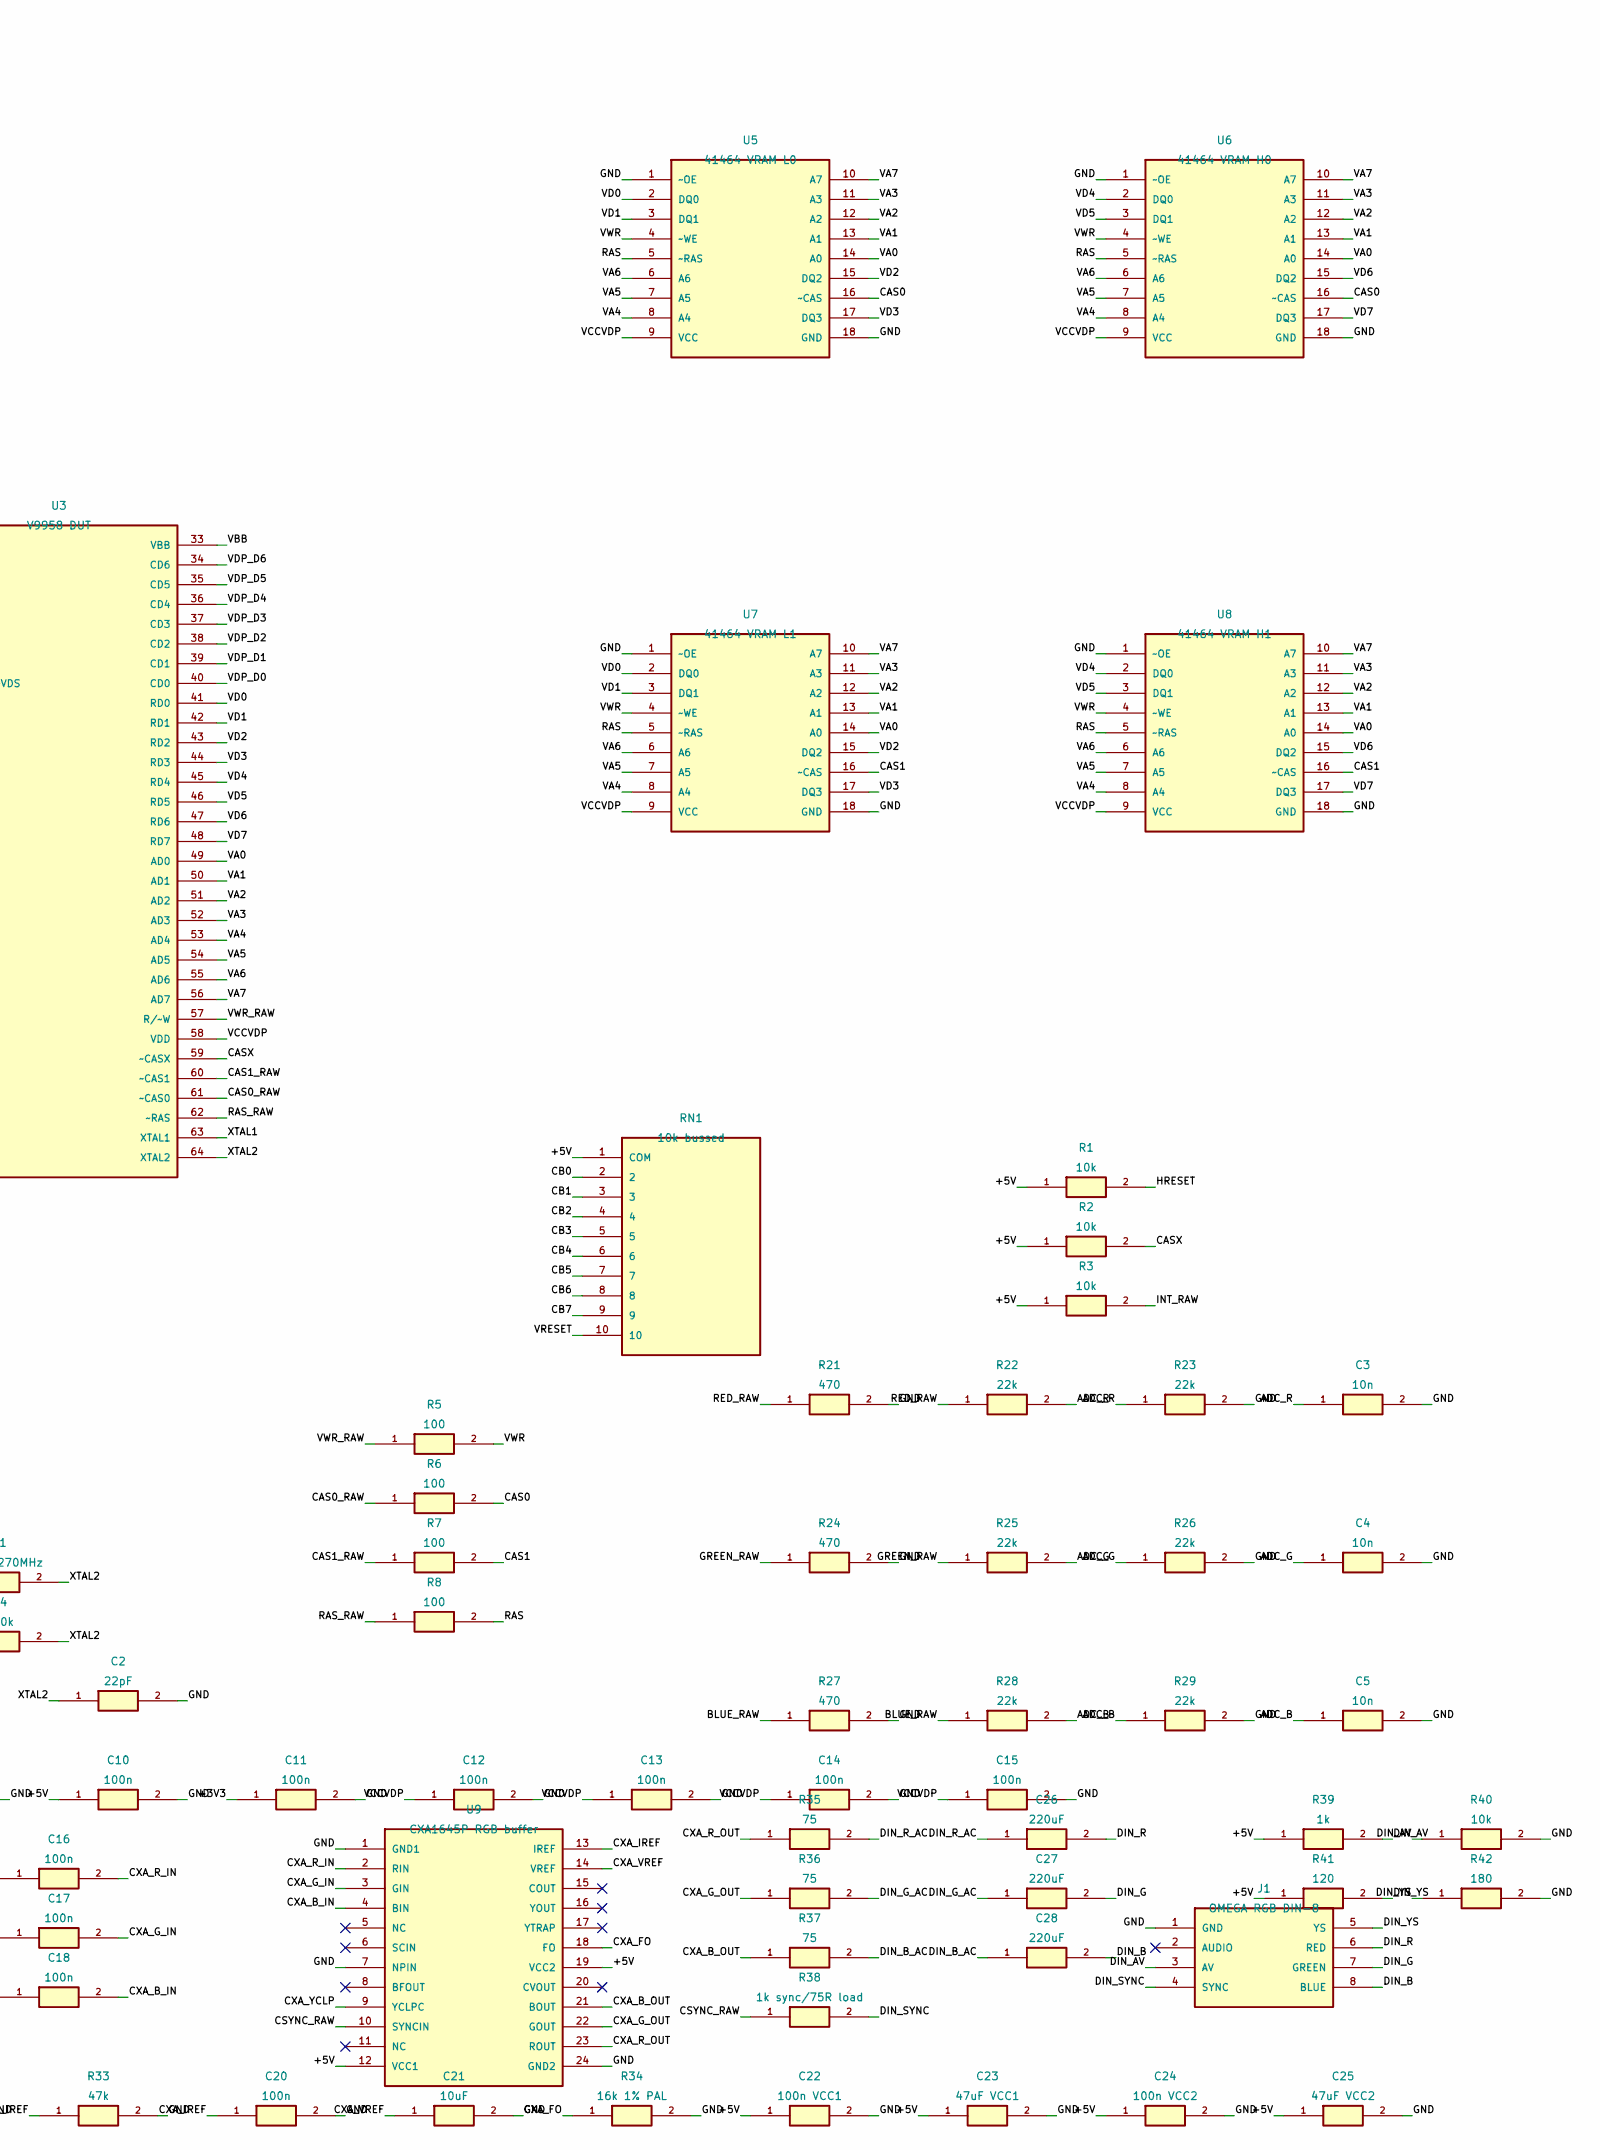
[picture p22: schematic V9958-Tester.kicad_sch, V9958 Pico Functional Tester, part in row 1, column 2]

Parts:
A1: Raspberry Pi Pico; RaspberryPi_Pico_Common_THT
C1: 30pF trimmer; C_Trim_P5.00mm
C2: 22pF; C_Disc_D5.0mm_W2.5mm_P5.00mm
C3, C4, C5: 10n; C_Disc_D5.0mm_W2.5mm_P5.00mm
C6: 100uF; CP_Radial_D5.0mm_P2.00mm
C7, C9, C10, C11, C12, C13, C14, C15, C16, C17, C18, C19, C20: 100n; C_Disc_D5.0mm_W2.5mm_P5.00mm
C8: 100n VBB; C_Disc_D5.0mm_W2.5mm_P5.00mm
C21: 10uF; CP_Radial_D5.0mm_P2.00mm
C22: 100n VCC1; C_Disc_D5.0mm_W2.5mm_P5.00mm
C23: 47uF VCC1; CP_Radial_D5.0mm_P2.00mm
C24: 100n VCC2; C_Disc_D5.0mm_W2.5mm_P5.00mm
C25: 47uF VCC2; CP_Radial_D5.0mm_P2.00mm
C26, C27, C28: 220uF; CP_Radial_D8.0mm_P3.50mm
D1: GREEN PASS; LED_D5.0mm
D2: RED FAIL; LED_D5.0mm
F1: Bourns MF-RHT100 PTC 1.0A; Fuse_Bourns_MF-RHT100
H1, H2, H3, H4: M3; MountingHole_3.2mm_M3
J1: OMEGA RGB DIN-8; DIN8_Omega_THT
L1: 5.6uH; L_Axial_L14.0mm_D4.5mm_P15.24mm_Horizontal_Fastron_LACC
R1, R2, R3, R14, R15, R16, R17, R18, R19, R20, R32, R40: 10k; R_Axial_DIN0207_L6.3mm_D2.5mm_P7.62mm_Horizontal
R4: 470k; R_Axial_DIN0207_L6.3mm_D2.5mm_P7.62mm_Horizontal
R5, R6, R7, R8: 100; R_Axial_DIN0207_L6.3mm_D2.5mm_P7.62mm_Horizontal
R9, R10, R11, R12, R13, R30, R31, R39: 1k; R_Axial_DIN0207_L6.3mm_D2.5mm_P7.62mm_Horizontal
R21, R24, R27: 470; R_Axial_DIN0207_L6.3mm_D2.5mm_P7.62mm_Horizontal
R22, R23, R25, R26, R28, R29: 22k; R_Axial_DIN0207_L6.3mm_D2.5mm_P7.62mm_Horizontal
R33: 47k; R_Axial_DIN0207_L6.3mm_D2.5mm_P7.62mm_Horizontal
R34: 16k 1% PAL; R_Axial_DIN0207_L6.3mm_D2.5mm_P7.62mm_Horizontal
R35, R36, R37: 75; R_Axial_DIN0207_L6.3mm_D2.5mm_P7.62mm_Horizontal
R38: 1k sync/75R load; R_Axial_DIN0207_L6.3mm_D2.5mm_P7.62mm_Horizontal
R41: 120; R_Axial_DIN0207_L6.3mm_D2.5mm_P7.62mm_Horizontal
R42: 180; R_Axial_DIN0207_L6.3mm_D2.5mm_P7.62mm_Horizontal
RN1: 10k bussed; R_Array_SIP10
SW1: TEST; SW_PUSH_6mm_H7.3mm
TP1: 5V; TestPoint_THTPad_D2.0mm_Drill1.0mm
TP2: 3V3; TestPoint_THTPad_D2.0mm_Drill1.0mm
TP3: GND; TestPoint_THTPad_D2.0mm_Drill1.0mm
TP4: CPUCLK; TestPoint_THTPad_D2.0mm_Drill1.0mm
TP5: HSYNC; TestPoint_THTPad_D2.0mm_Drill1.0mm
TP6: CSYNC; TestPoint_THTPad_D2.0mm_Drill1.0mm
TP7: RED; TestPoint_THTPad_D2.0mm_Drill1.0mm
TP8: GREEN; TestPoint_THTPad_D2.0mm_Drill1.0mm
TP9: BLUE; TestPoint_THTPad_D2.0mm_Drill1.0mm
U1: SN74LVC245AN; DIP-20_W7.62mm_Socket_LongPads
U2: SN74AHCT244N; DIP-20_W7.62mm_Socket_LongPads
U3: V9958 DUT; SDIP-64_W19.05mm_P1.778mm_Socket
U4: SN74LVC244AN; DIP-20_W7.62mm_Socket_LongPads
U5: 41464 VRAM L0; DIP-18_W7.62mm_Socket_LongPads
U6: 41464 VRAM H0; DIP-18_W7.62mm_Socket_LongPads
U7: 41464 VRAM L1; DIP-18_W7.62mm_Socket_LongPads
U8: 41464 VRAM H1; DIP-18_W7.62mm_Socket_LongPads
U9: CXA1645P RGB buffer; DIP-24_W10.16mm_Socket_LongPads
Y1: 21.477270MHz; Crystal_HC49-U_Vertical

Connections:
/+3V3: A1.36 (3V3_OUT), C9.1, C11.1, R16.2, R17.2, R20.2, R32.2, TP2.1, U1.20 (VCC), U4.20 (VCC)
/+5V: C10.1, C22.1, C23.1, C24.1, C25.1, F1.2, L1.1, R1.1, R2.1, R3.1, R39.1, R41.1, RN1.1 (COM), TP1.1, U2.20 (VCC), U9.12 (VCC1), U9.19 (VCC2)
/ADC_B: A1.34 (GP28_ADC2), C5.1, R28.2, R29.1
/ADC_G: A1.32 (GP27_ADC1), C4.1, R25.2, R26.1
/ADC_R: A1.31 (GP26_ADC0), C3.1, R22.2, R23.1
/BLUE_RAW: C18.1, R27.1, R28.1, TP9.1, U3.24 (B)
/BUS_DIR: A1.16 (GP12), R19.1, U1.1 (DIR)
/BUS_OE_N: A1.17 (GP13), R20.1, U1.19 (~OE)
/CAS0: R6.2, U5.16 (~CAS), U6.16 (~CAS)
/CAS0_RAW: R6.1, U3.61 (~CAS0)
/CAS1: R7.2, U7.16 (~CAS), U8.16 (~CAS)
/CAS1_RAW: R7.1, U3.60 (~CAS1)
/CASX: R2.2, U3.59 (~CASX)
/CB0: RN1.2, U3.19 (C0)
/CB1: RN1.3, U3.18 (C1)
/CB2: RN1.4, U3.17 (C2)
/CB3: RN1.5, U3.16 (C3)
/CB4: RN1.6, U3.15 (C4)
/CB5: RN1.7, U3.14 (C5)
/CB6: RN1.8, U3.13 (C6)
/CB7: RN1.9, U3.12 (C7)
/CPUCLK_5: R9.2, U4.2 (1A1)
/CPUCLK_RAW: R9.1, TP4.1, U3.8 (CPUCLK/~VDS)
/CSYNC_5: R11.2, U4.6 (1A3)
/CSYNC_RAW: R11.1, R38.1, TP6.1, U3.6 (~CSYNC), U9.10 (SYNCIN)
/CTRL_CSR_IN: A1.15 (GP11), R17.1, U2.8 (1A4)
/CTRL_CSW_IN: A1.14 (GP10), R16.1, U2.6 (1A3)
/CTRL_MODE0_IN: A1.11 (GP8), R14.1, U2.2 (1A1)
/CTRL_MODE1_IN: A1.12 (GP9), R15.1, U2.4 (1A2)
/CTRL_RESET_IN: A1.19 (GP14), R18.1, U2.11 (2A1)
/CXA_B_IN: C18.2, U9.4 (BIN)
/CXA_B_OUT: R37.1, U9.21 (BOUT)
/CXA_FO: R34.1, U9.18 (FO)
/CXA_G_IN: C17.2, U9.3 (GIN)
/CXA_G_OUT: R36.1, U9.22 (GOUT)
/CXA_IREF: C20.1, R33.1, U9.13 (IREF)
/CXA_R_IN: C16.2, U9.2 (RIN)
/CXA_R_OUT: R35.1, U9.23 (ROUT)
/CXA_VREF: C21.1, U9.14 (VREF)
/CXA_YCLP: C19.1, U9.9 (YCLPC)
/DIN_AV: J1.3 (AV), R39.2, R40.1
/DIN_B: C28.2, J1.8 (BLUE)
/DIN_B_AC: C28.1, R37.2
/DIN_G: C27.2, J1.7 (GREEN)
/DIN_G_AC: C27.1, R36.2
/DIN_R: C26.2, J1.6 (RED)
/DIN_R_AC: C26.1, R35.2
/DIN_SYNC: J1.4 (SYNC), R38.2
/DIN_YS: J1.5 (YS), R41.2, R42.1
/GND: A1.3 (GND), A1.8 (GND), A1.13 (GND), A1.18 (GND), A1.23 (GND), A1.28 (GND), A1.33 (AGND), A1.38 (GND), C1.2, C2.2, C3.2, C4.2, C5.2, C6.2, C7.2, C8.2, C9.2, C10.2, C11.2, C12.2, C13.2, C14.2, C15.2, C19.2, C20.2, C21.2, C22.2, C23.2, C24.2, C25.2, D1.1, D2.1, J1.1 (GND), R14.2, R15.2, R18.2, R19.2, R21.2, R23.2, R24.2, R26.2, R27.2, R29.2, R33.2, R34.2, R40.2, R42.2, SW1.2, TP3.1, U1.10 (GND), U2.1 (~1OE), U2.10 (GND), U2.13 (2A2), U2.15 (2A3), U2.17 (2A4), U2.19 (~2OE), U3.1 (GND), U3.20 (GND_DAC), U4.1 (~1OE), U4.10 (GND), U4.13 (2A2), U4.15 (2A3), U4.17 (2A4), U4.19 (~2OE), U5.1 (~OE), U5.18 (GND), U6.1 (~OE), U6.18 (GND), U7.1 (~OE), U7.18 (GND), U8.1 (~OE), U8.18 (GND), U9.1 (GND1), U9.7 (NPIN), U9.24 (GND2)
/GREEN_RAW: C17.1, R24.1, R25.1, TP8.1, U3.22 (G)
/HRESET: R1.2, U3.27 (~HRESET)
/HSYNC_5: R10.2, U4.4 (1A2)
/HSYNC_RAW: R10.1, TP5.1, U3.5 (~HSYNC)
/INT_5: R13.2, U4.11 (2A1)
/INT_RAW: R3.2, R13.1, U3.25 (~INT)
/LED_GREEN: A1.20 (GP15), R30.1
/LED_GREEN_A: D1.2, R30.2
/LED_RED: A1.21 (GP16), R31.1
/LED_RED_A: D2.2, R31.2
/MON_CPUCLK: A1.22 (GP17), U4.18 (1Y1)
/MON_CSYNC: A1.27 (GP21), U4.14 (1Y3)
/MON_HSYNC: A1.25 (GP19), U4.16 (1Y2)
/MON_INT: A1.26 (GP20), U4.9 (2Y1)
/MON_WAIT: A1.24 (GP18), U4.12 (1Y4)
/P_D0: A1.1 (GP0), U1.2 (A0)
/P_D1: A1.2 (GP1), U1.3 (A1)
/P_D2: A1.4 (GP2), U1.4 (A2)
/P_D3: A1.5 (GP3), U1.5 (A3)
/P_D4: A1.6 (GP4), U1.6 (A4)
/P_D5: A1.7 (GP5), U1.7 (A5)
/P_D6: A1.9 (GP6), U1.8 (A6)
/P_D7: A1.10 (GP7), U1.9 (A7)
/RAS: R8.2, U5.5 (~RAS), U6.5 (~RAS), U7.5 (~RAS), U8.5 (~RAS)
/RAS_RAW: R8.1, U3.62 (~RAS)
/RED_RAW: C16.1, R21.1, R22.1, TP7.1, U3.23 (R)
/TEST_BUTTON: A1.29 (GP22), R32.1, SW1.1
/VA0: U3.49 (AD0), U5.14 (A0), U6.14 (A0), U7.14 (A0), U8.14 (A0)
/VA1: U3.50 (AD1), U5.13 (A1), U6.13 (A1), U7.13 (A1), U8.13 (A1)
/VA2: U3.51 (AD2), U5.12 (A2), U6.12 (A2), U7.12 (A2), U8.12 (A2)
/VA3: U3.52 (AD3), U5.11 (A3), U6.11 (A3), U7.11 (A3), U8.11 (A3)
/VA4: U3.53 (AD4), U5.8 (A4), U6.8 (A4), U7.8 (A4), U8.8 (A4)
/VA5: U3.54 (AD5), U5.7 (A5), U6.7 (A5), U7.7 (A5), U8.7 (A5)
/VA6: U3.55 (AD6), U5.6 (A6), U6.6 (A6), U7.6 (A6), U8.6 (A6)
/VA7: U3.56 (AD7), U5.10 (A7), U6.10 (A7), U7.10 (A7), U8.10 (A7)
/VBB: C8.1, U3.33 (VBB)
/VBUS_USB: A1.40 (VBUS), F1.1
/VCCVDP: C6.1, C7.1, C12.1, C13.1, C14.1, C15.1, L1.2, U3.21 (VDD_DAC), U3.58 (VDD), U5.9 (VCC), U6.9 (VCC), U7.9 (VCC), U8.9 (VCC)
/VD0: U3.41 (RD0), U5.2 (DQ0), U7.2 (DQ0)
/VD1: U3.42 (RD1), U5.3 (DQ1), U7.3 (DQ1)
/VD2: U3.43 (RD2), U5.15 (DQ2), U7.15 (DQ2)
/VD3: U3.44 (RD3), U5.17 (DQ3), U7.17 (DQ3)
/VD4: U3.45 (RD4), U6.2 (DQ0), U8.2 (DQ0)
/VD5: U3.46 (RD5), U6.3 (DQ1), U8.3 (DQ1)
/VD6: U3.47 (RD6), U6.15 (DQ2), U8.15 (DQ2)
/VD7: U3.48 (RD7), U6.17 (DQ3), U8.17 (DQ3)
/VDP_CSR_N: U2.12 (1Y4), U3.31 (~CSR)
/VDP_CSW_N: U2.14 (1Y3), U3.30 (~CSW)
/VDP_D0: U1.18 (B0), U3.40 (CD0)
/VDP_D1: U1.17 (B1), U3.39 (CD1)
/VDP_D2: U1.16 (B2), U3.38 (CD2)
/VDP_D3: U1.15 (B3), U3.37 (CD3)
/VDP_D4: U1.14 (B4), U3.36 (CD4)
/VDP_D5: U1.13 (B5), U3.35 (CD5)
/VDP_D6: U1.12 (B6), U3.34 (CD6)
/VDP_D7: U1.11 (B7), U3.32 (CD7)
/VDP_MODE0: U2.18 (1Y1), U3.29 (MODE0)
/VDP_MODE1: U2.16 (1Y2), U3.28 (MODE1)
/VDP_RESET_N: U2.9 (2Y1), U3.9 (~RESET)
/VRESET: RN1.10, U3.4 (~VRESET)
/VWR: R5.2, U5.4 (~WE), U6.4 (~WE), U7.4 (~WE), U8.4 (~WE)
/VWR_RAW: R5.1, U3.57 (R/~W)
/WAIT_5: R12.2, U4.8 (1A4)
/WAIT_RAW: R12.1, U3.26 (~WAIT)
/XTAL1: C1.1, R4.1, U3.63 (XTAL1), Y1.1
/XTAL2: C2.1, R4.2, U3.64 (XTAL2), Y1.2

Notes on the sheet:
V9958 PICO FUNCTIONAL TESTER - PROTOTYPE REV 0.3
Checks V9958 ID, CPU interface, 128 KiB VRAM, clocks/sync, interrupt and RGB response; buffered DIN RGB output.
WARNING: power off before inserting/removing V9958 or VRAM. Use a current-limited 5V / 1A USB supply.
Behavioral V9958 test only; a pass is not forensic proof of Yamaha manufacture.

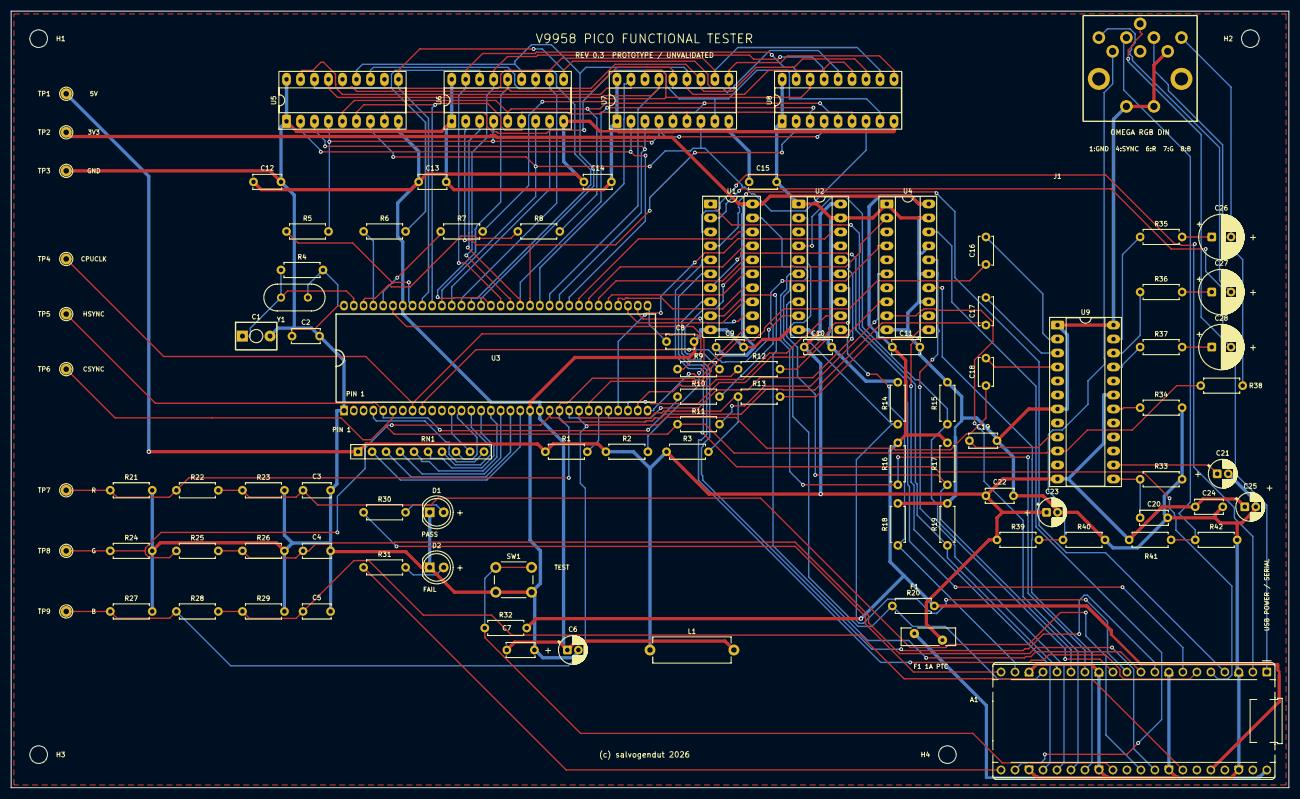
[picture p23: board V9958-Tester.kicad_pcb from above]

Board: 2 copper layers, 232.0 x 141.0 mm, 101 parts (0 on the bottom side), 116 nets.
