salvogendut/V9958-tester/(commit log)

2026-11-06 Initial V9958 Pico functional tester design
    [BOM.csv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]
2026-11-06 Add Omega DIN RGB output and on-screen status
    [BOM.csv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]
2026-11-06 Label silkscreen and mark component polarity
    [V9958-Tester-B_Cu.gbl, V9958-Tester-B_Mask.gbs, V9958-Tester-B_Silkscreen.gbo, V9958-Tester-Edge_Cuts.gm1, V9958-Tester-F_Cu.gtl, V9958-Tester-F_Mask.gts, V9958-Tester-F_Silkscreen.gto, V9958-Tester-NPTH.drl]
2026-11-06 Add minimal Revision B tester and RGB daughterboard
    [BOM.csv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]
2026-11-06 Add SRAM-based Revision B2 tester
    [BOM.csv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]
